Edragon/CMIOT/5_宣传彩页/02.jpg

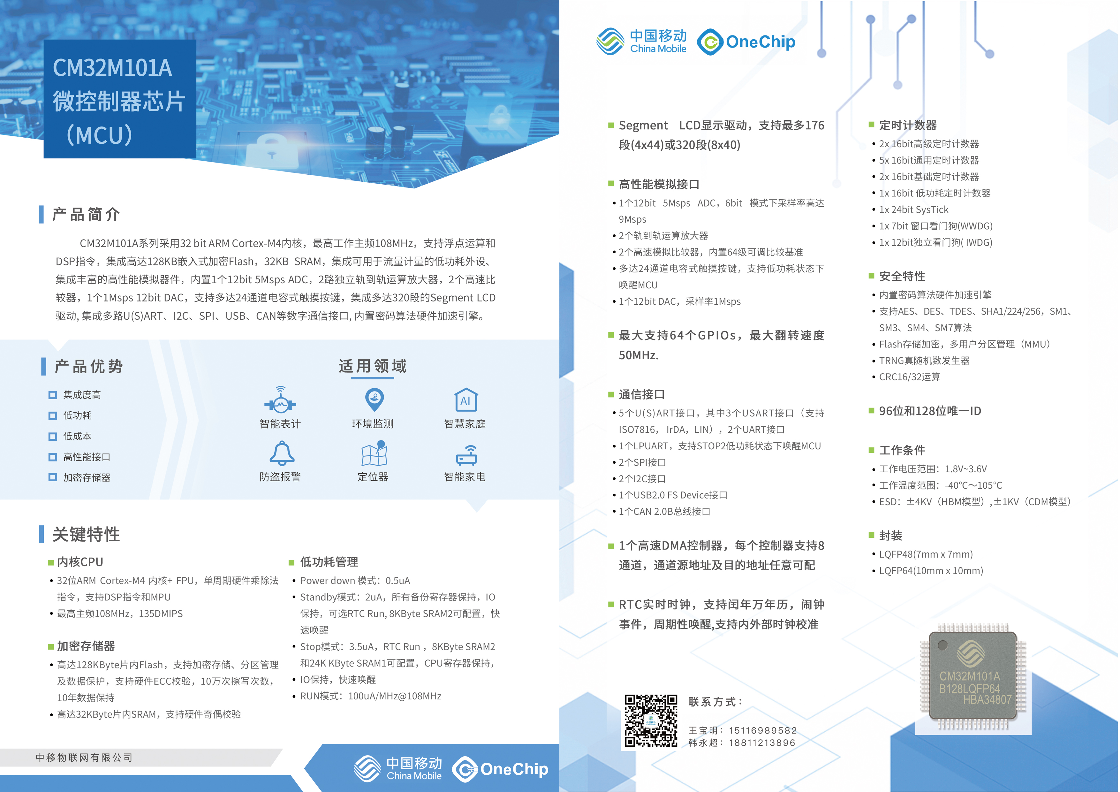
5_宣传彩页/02.jpg
