Edragon/CMIOT/5_宣传彩页/01.jpg

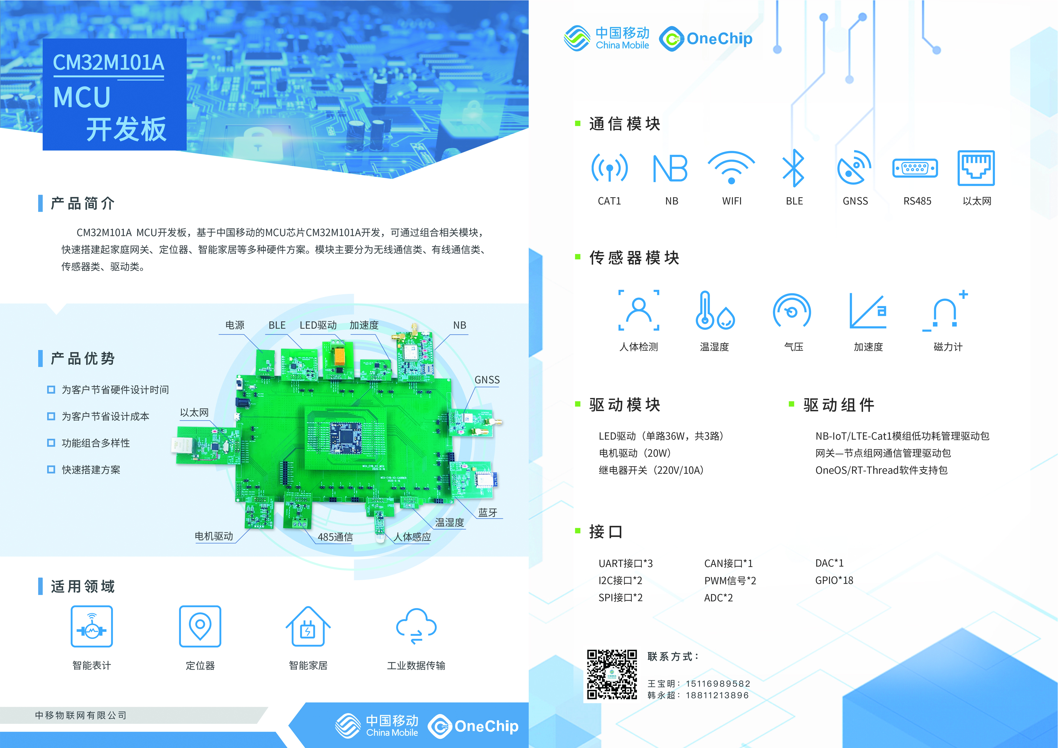
5_宣传彩页/01.jpg
