Edragon/CMIOT/4_方案板的硬件资料+含使用手册/方案板使用说明V1.1.pdf

中移物联网有限公司

# MCU 方案板使用说明

V1.1

版本 | 修改人 | 日期 | 备注
V1.0 | HuangLun | 2020.10.14 | 新建
V1.1 | HuangLun | 2020.11.27 | 增加若干内容

中移物联网有限公司

## 一、底板

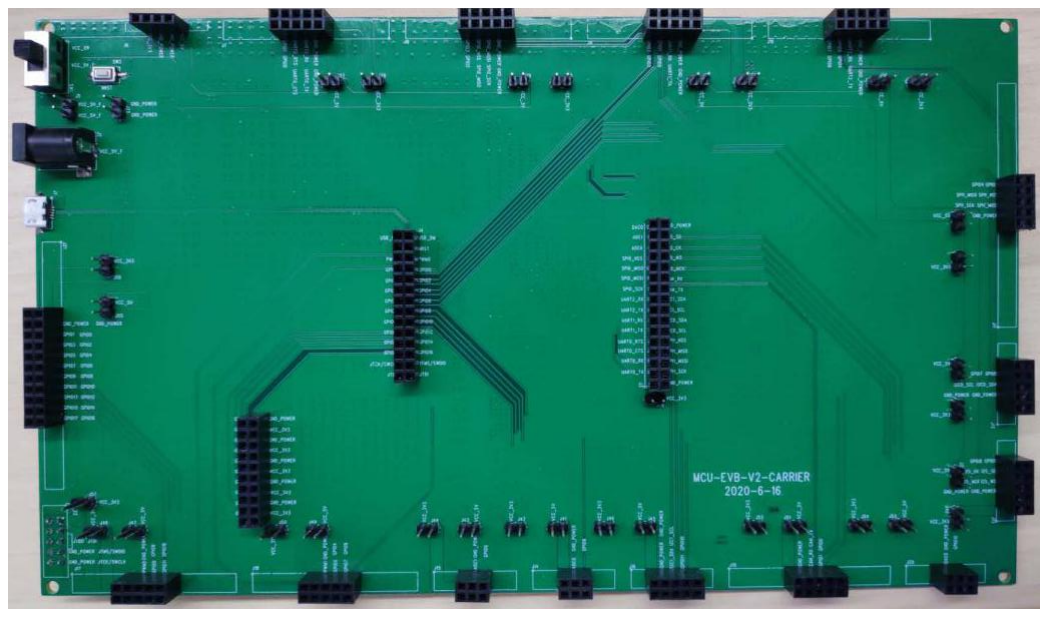
[picture p3: figure]

底板上的各模块工作，必须有电源模块。

## 1.1 电源

要求 5V 电压输出。三种输入方式：
1）适配器 DC 电源输出
2）USB 电源输入
3）其他外接电源

图 1.1.1
每个接口位置都有跳针，连接后，接口位置才通电。

比如 MCU 核心板通电，J26 跳针必须插上跳线帽。

中移物联网有限公司

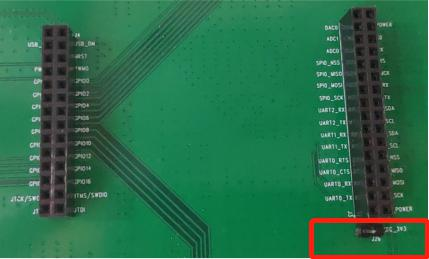
[picture p4: figure]

图 1.1.2
开关控制电源通断。按键是 MCU 的复位按键。

图 1.1.3

## 1.2 接口

各接口位置如图 1.2。

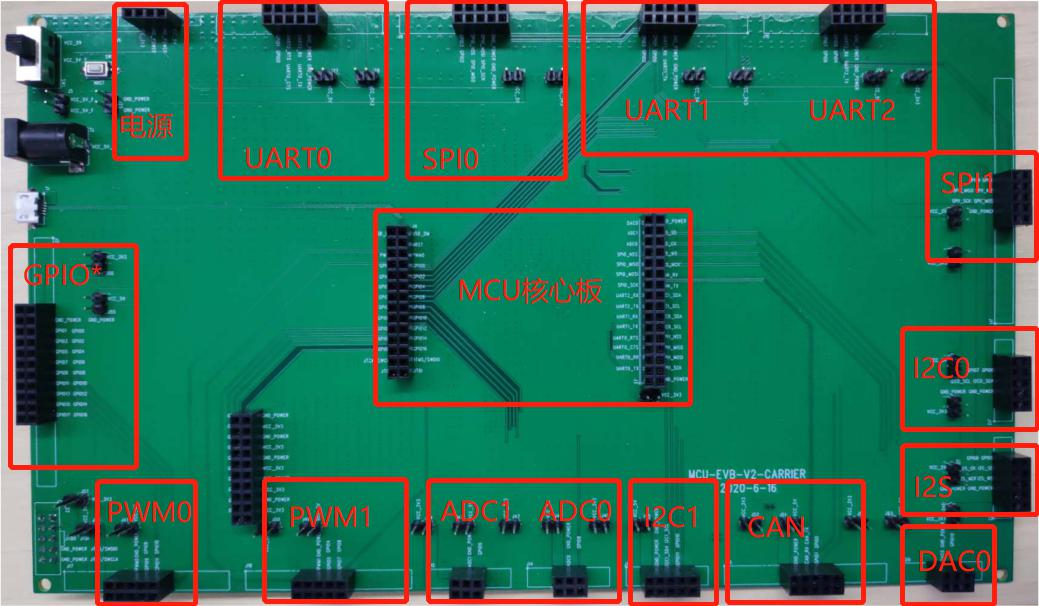
[picture p5: figure]

图 1.2

底板所有接口的 1PIN 为 5V，2PIN 为 3.3V，在底板上没有丝印。

中移物联网有限公司
从 3PIN 开始有丝印。底板各接口与 MCU 管脚对应关系见附录一。 二、MCU 核心板

## 1.1 电源

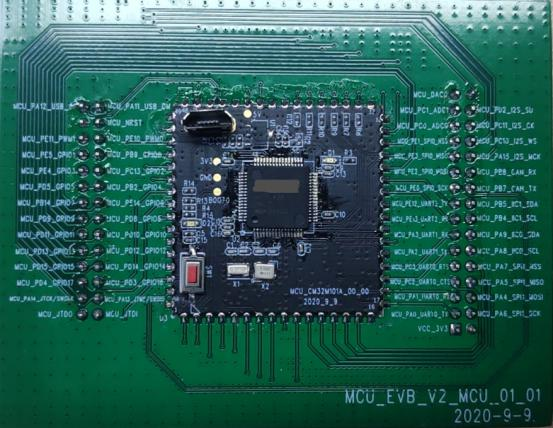
[picture p6: figure]

单独使用核心板时，可通过核心板上的 micro-USB 供电，需要焊接 R6 电阻。

核心板与底板共同使用时，由底板供电，焊接 R2。

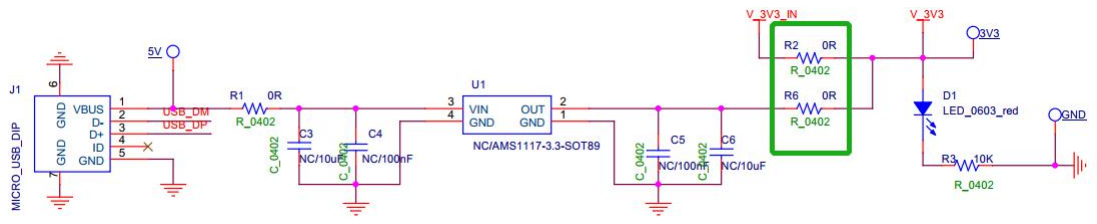
[picture p7: figure]

图 1.1

## 1.2 指示灯

电源上电指示灯为 D1。如图 1.2.1，MCU 通电电源指示灯亮。

调试指示灯 D2 连接在 PIN60_BOOT0。初上电时，BOOT0 通过 R4,R15 处于下

拉状态。如图 1.2.2。

中移物联网有限公司

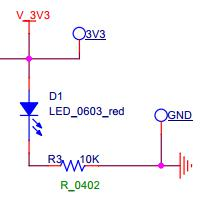
[picture p8: figure]

图 1.2.1

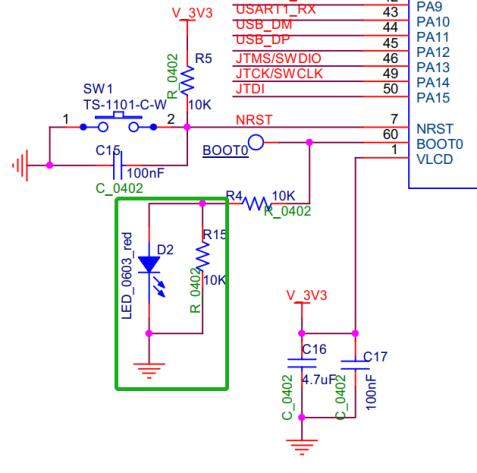
[picture p9: figure]

图 1.2.2

## 1.3 复位

板上有一枚复位按键。

图 1.3

### 1.3 核心板引出引脚（黑色板）

下图为 64PIN_MCU 所有管脚。

中移物联网有限公司

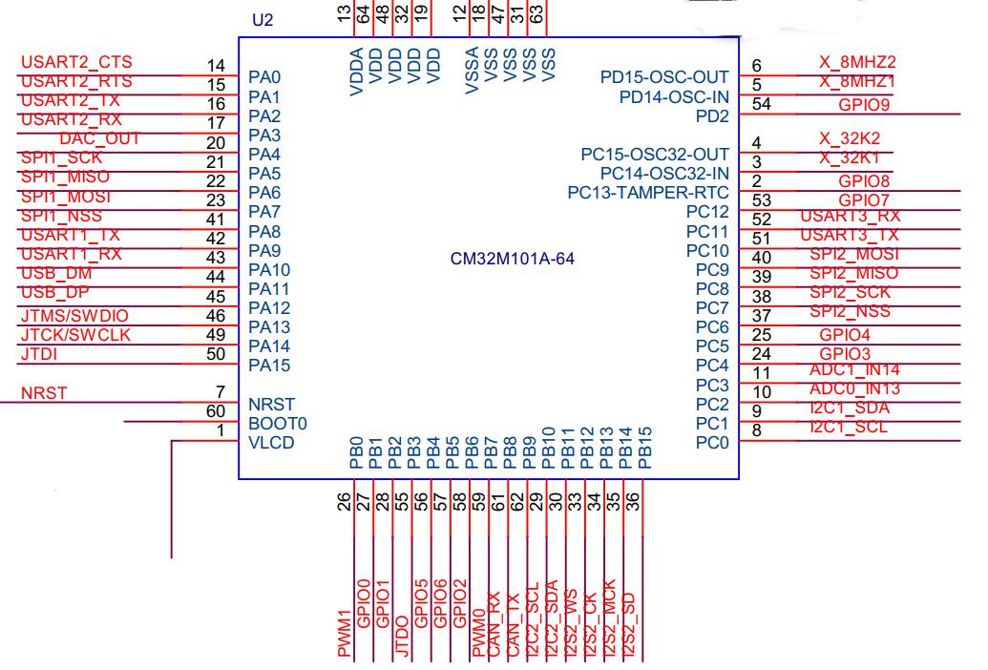
[picture p10: figure]

下图为邮票孔定义。

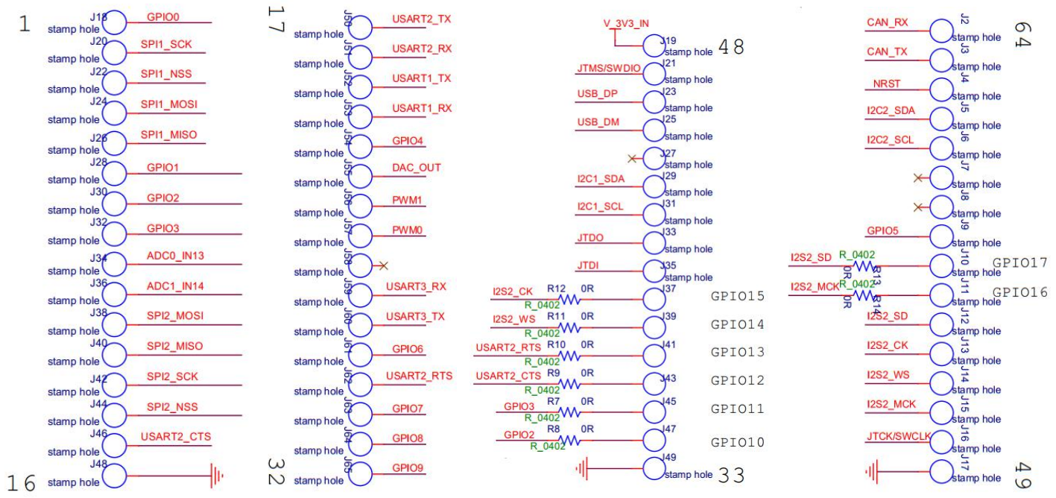
[picture p11: figure]

### 1.5 核心板与底板对应关系

核心板插在底板上，管脚对应关系见表 1.4。

表 1.4
管脚编号 | MCU 核心板管脚名称 | 底板接口对应名称
| | 复用管脚
8 | PC0 I2C1_SCL | | I2C0_SCL
9 | PC1 I2C1_SDA | | I2C0_SDA
29 | PB10 I2C2_SCL | | I2C1_SCL
30 | PB11 I2C2_SDA | | I2C1_SDA

中移物联网有限公司

33 | PB12 I2S2_WS | GPIO14 | I2S1_WS
34 | PB13 I2S2_CK | GPIO15 | I2S1_CK
35 | PB14 I2S2_MCK | GPIO16 | I2S1_MCK
36 | PB15 I2S2_SD | GPIO17 | I2S1_SD
21 | PA5 SPI1_SCK | SPI0_SCK
22 | PA6 SPI1_MISO | SPI0_MISO
23 | PA7 SPI1_MOSI | SPI0_MOSI
41 | PA8 SPI1_NSS | SPI0_NSS
37 | PC6 SPI2_NSS | SPI1_NSS
38 | PC7 SPI2_SCK | SPI1_SCK
39 | PC8 SPI2_MISO | SPI1_MISO
40 | PC9 SPI2_MOSI | SPI1_MOSI
10 | PC2 ADC0_IN13 | ADC0_IN13
11 | PC3 ADC1_IN14 | ADC1_IN14
20 | PA4 DAC_OUT | DAC_OUT
14 | PA0 USART2_CTS | GPIO12 | UART0_CTS
15 | PA1 USART2_RTS | GPIO13 | UART0_RTS
16 | PA2 USART2_TX | | UART0_TX
17 | PA3 USART2_RX | | UART0_RX
42 | PA9 USART1_TX | | UART1_TX
43 | PA10 USART1_RX | | UART1_RX
56 | PC10 | USART3_TX/UART4_TX USART3_RX/UART4_RX | | UART2_TX
57 | PC11 | | | UART2_RX
61 | PB8 CAN_RX | CAN_RX
62 | PB9 CAN_TX | CAN_TX
26 | PB0 TIM1_CH2N/TIM3_CH3 | PWM1
59 | PB7 TIM4_CH2 | PWM0
44 | PA11 USB_DM | USB_DM
45 | PA12 USB_DP | USB_DP
46 | PA13 JTMS/SWDIO | JTMS/SWDIO

中移物联网有限公司
49 | PA14 JTCK/SWCLK | JTCK/SWCLK
50 | PA15 JTDI | JTDI
55 | PB3 JTDO-TRACESWO | JTDO-TRACESWO
2 | PC13 | GPIO8 | | GPIO8
51 | PB4 | GPIO5 | | GPIO5
52 | PB5 | GPIO6 | | GPIO6
53 | PC12 | GPIO7 | | GPIO7
54 | PD2 | GPIO9 | | GPIO9
58 | PB6 | GPIO2 | GPIO10 | GPIO2
24 | PC4 | GPIO3 | GPIO11 | GPIO3
25 | PC5 | GPIO4 | | GPIO4
27 | PB1 | GPIO0 | | GPIO0
28 | PB2 | GPIO1 | | GPIO1

# 三、电源板

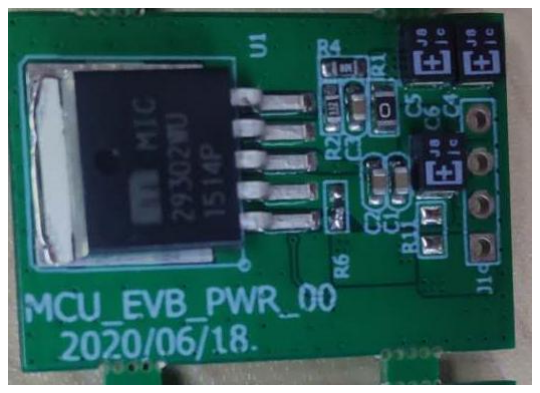
[picture p12: figure]
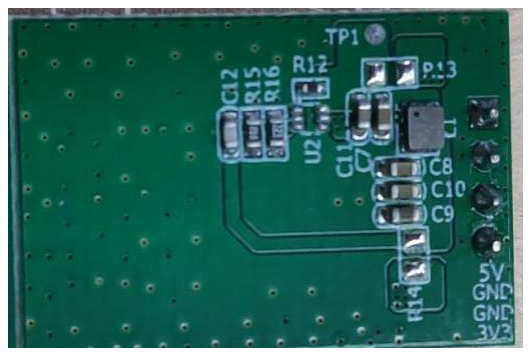
[picture p13: figure]

LDO | DC/DC

## 1.2 接口

插在底板 POWER 接口。

中移物联网有限公司

## 1.3 电源

电源有两种供电方式。只能选择一种方式供电，不能同时使用。

第一种是使用 LDO，如图 1.1。需焊接 R11,R1 电阻，同时断开另一面 R13,R14

电阻。

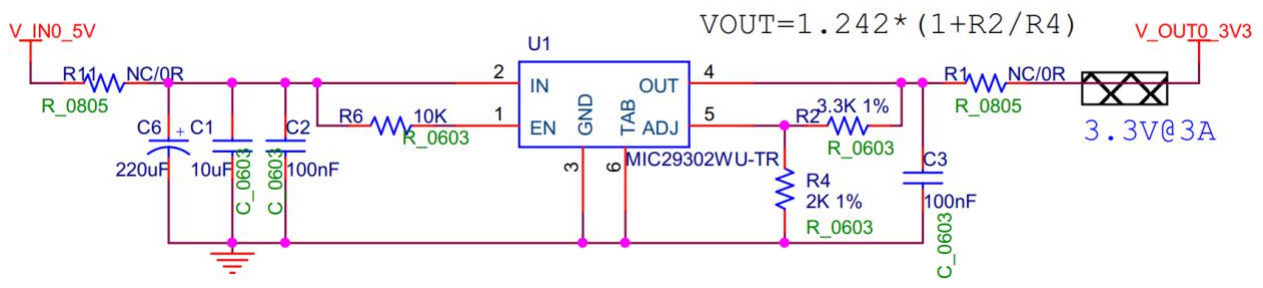
[picture p14: figure]

图 1.1
第二种是使用 DC/DC，如图 1.2，需焊接 R13,R14.同时断开 R11,R1。

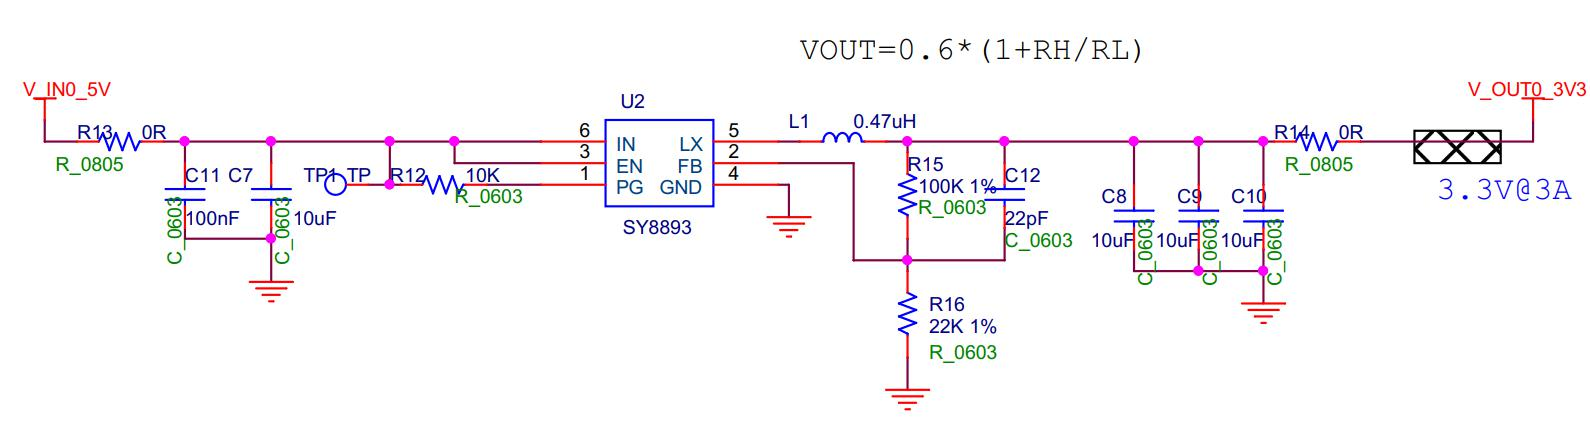
[picture p15: figure]

图 1.2

# 四、NB 板

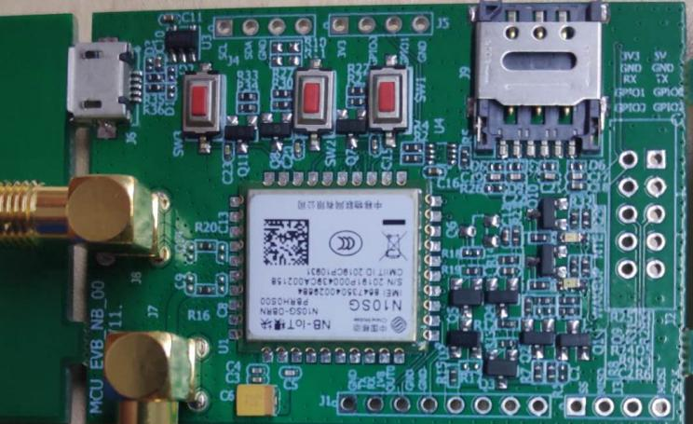
[picture p16: figure]

中移物联网有限公司

### 1.1 接口定义

接在底板 UART 接口。详见附录二。

USB 不能供电，是打印 LOG 用端口。

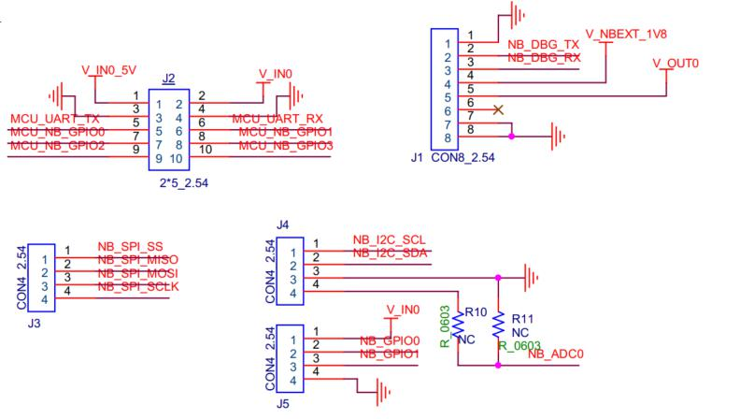
[picture p17: figure]

图 1.1

## 1.2 电源

有两种供电方式：

一是使用底板上 3.3V，焊接 R15，断开 R17。同时底板各 UART 接口的 PIN9

需要拉高；拉低时电源被关断。

二是使用 NB 板上电源供电。需焊接 R17，断开 R15。同时底板各 UART 接口

的 PIN9 需要拉高；拉低时电源被关断。

注：USB 接口不能为 NB 模组供电。

中移物联网有限公司

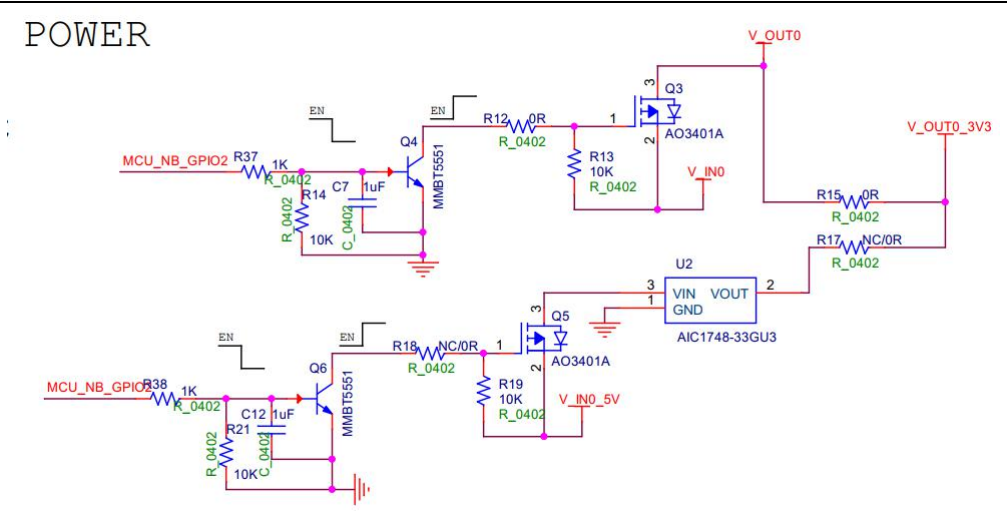
[picture p18: figure]

图 1.2.1

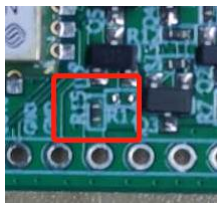
[picture p19: figure]

图 1.2.2

## 1.3 指示灯

D5 连接 wakeup_out，D4 连接 STATE。

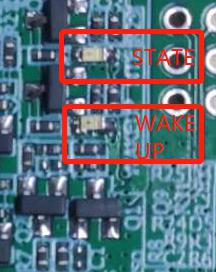
[picture p20: figure]

图 1.3

## 1.4 控制

中移物联网有限公司

# 1.4.1 复位

控制模组复位，底板各 UART 接口 PIN7 拉高复位。

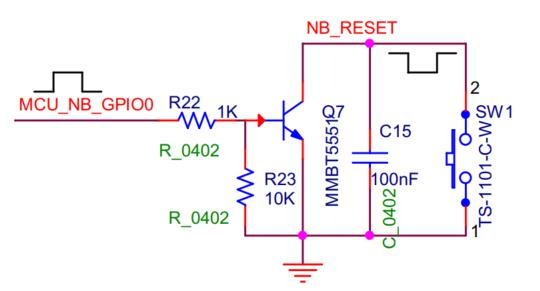
[picture p21: figure]

图 1.4.1

# 1.4.2 唤醒

唤醒模组，底板各 UART 接口 PIN8 拉高 1S 以上唤醒。

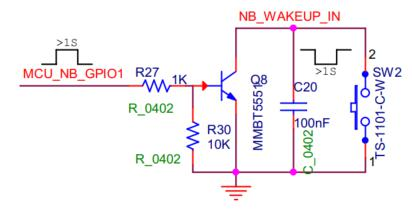
[picture p22: figure]

图 1.4.2

# 1.4.3 开机

底板各 UART 接口 PIN10 拉高 1S 以上开机。

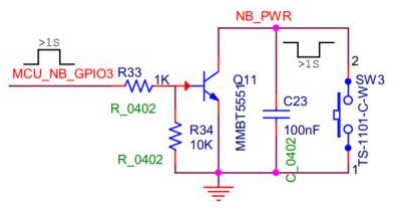
[picture p23: figure]

图 1.4.3

中移物联网有限公司

# 五、CAT1 板

### 1.1 接口定义

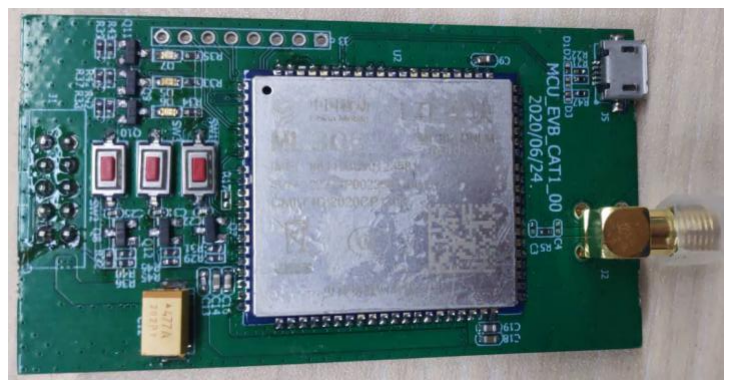
[picture p24: figure]

接在底板 UART 接口上。详见附录二。

USB 端口连接在 CAT1 USB 功能接口上。

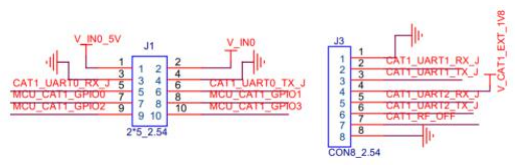
[picture p25: figure]

图 1.1

## 1.2 电源

CAT1 的电源由子板上电源单独供电。由底板输入 5V，需要连接 5V 跳针。输

出 4V。

注:USB 接口电源不能为模组供电。

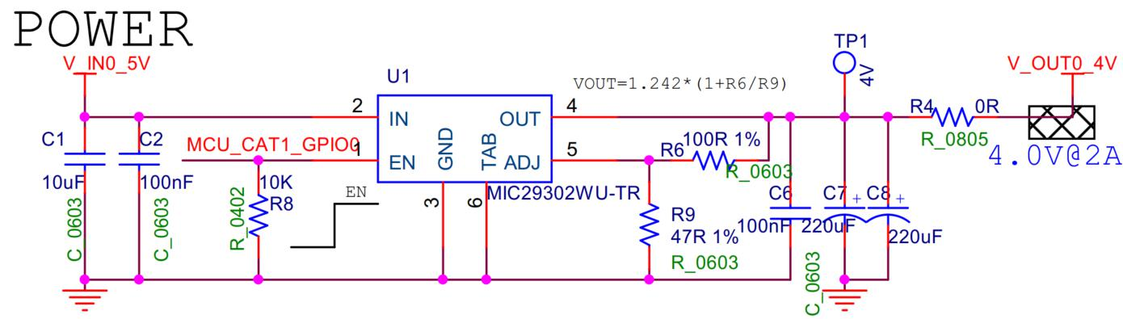
[picture p26: figure]

中移物联网有限公司
图 1.2

## 1.3 指示灯

D5 为 MOD 指示灯。D6 为 STATE 指示灯。D7 为 wakeup 指示灯。

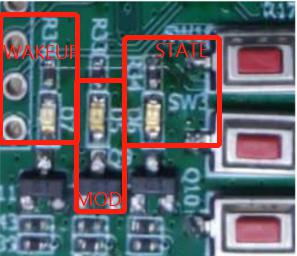
[picture p27: figure]

图 1.3

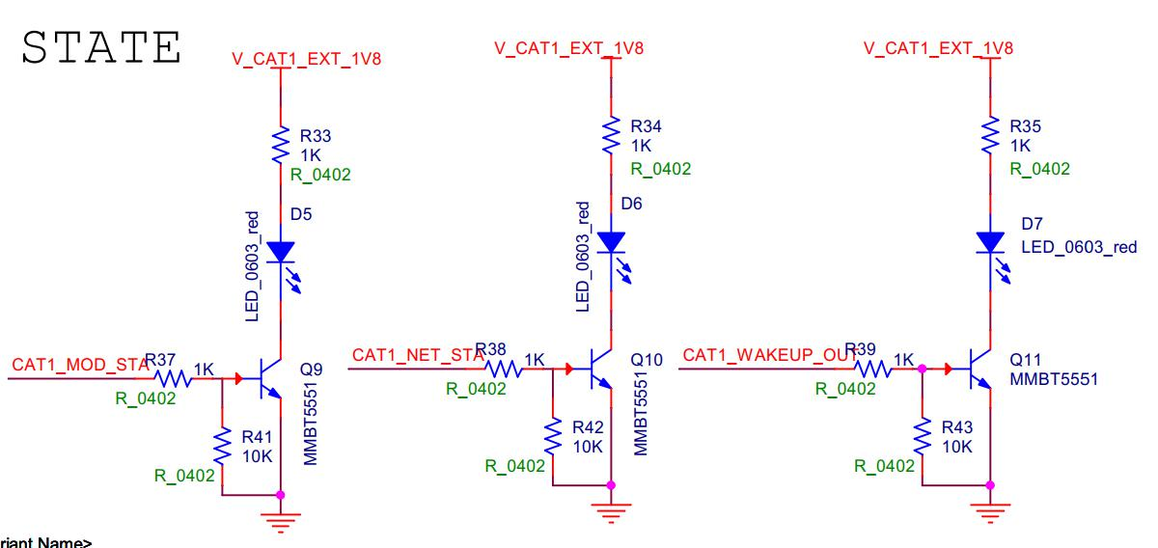
[picture p28: figure]

## 1.4 控制

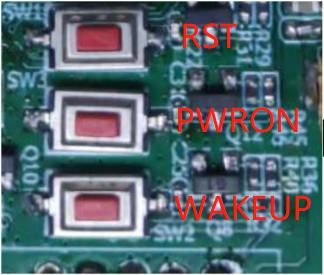
[picture p29: figure]

图 1.4

中移物联网有限公司

# 1.4.1 复位

控制模组复位，底板各 UART 接口 PIN8 拉高复位。

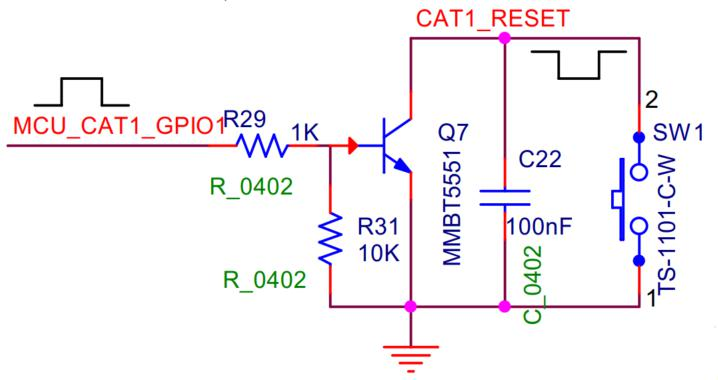
[picture p30: figure]

图 1.4.1

# 1.4.2 唤醒

唤醒模组，底板各 UART 接口 PIN9 拉低 1S 以上唤醒。

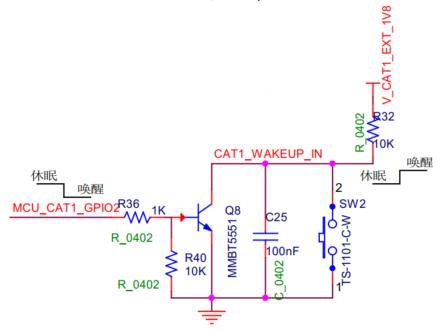
[picture p31: figure]

图 1.4.2

# 1.4.3 开机

底板各 UART 接口 PIN10 拉高 1S 以上开机。

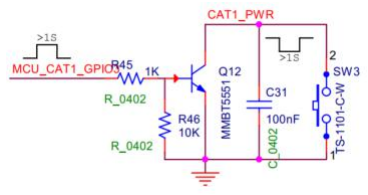
[picture p32: figure]

图 1.4.3

中移物联网有限公司

# 六、GNSS 板

## 1.1 接口

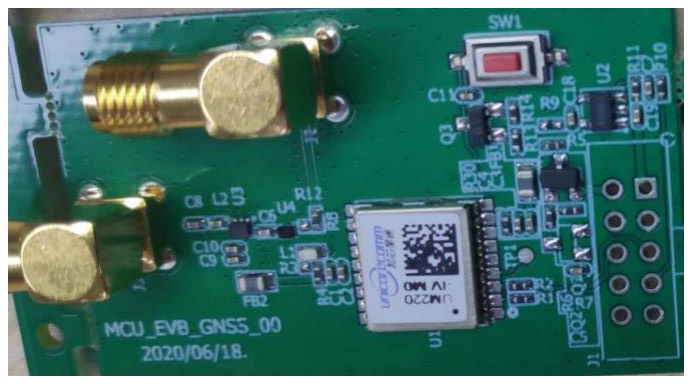
[picture p33: figure]

接在底板 UART 接口。详见附录二。

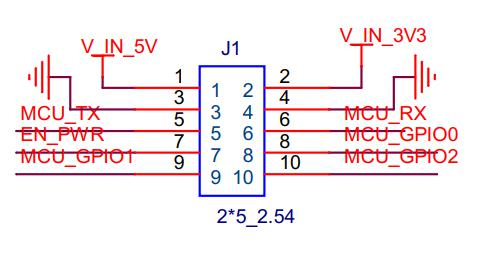
[picture p34: figure]

图 1.1

## 1.2 电源

有两种供电方式，

一是使用底板上 3.3V，焊接 R5，断开 R9。同时各 UART 接口的 PIN7 需要拉

高；拉低时电源被关断。

二是使用 GNSS 板上电源供电。需焊接 R9，断开 R5。同时各 UART 接口的 PIN7

需要拉高；拉低时电源被关断。

中移物联网有限公司

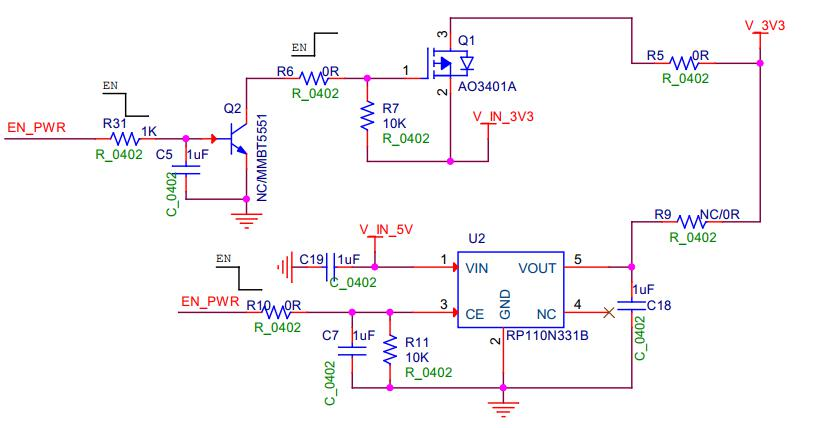
[picture p35: figure]

图 1.2.1

图 1.2.2

## 1.3 控制

控制模组复位，底板各 UART 接口 PIN8 拉高复位。

图 1.3.1

## 1.4 天线

使用有源天线时，天线连接 J2，需焊接 0 欧姆电阻 R8,R3，断开 R4,R12。

使用无源 RF 时，天线连接在 J3，焊接 0 欧姆电阻 R4,R12，断开 R8,R3。

中移物联网有限公司

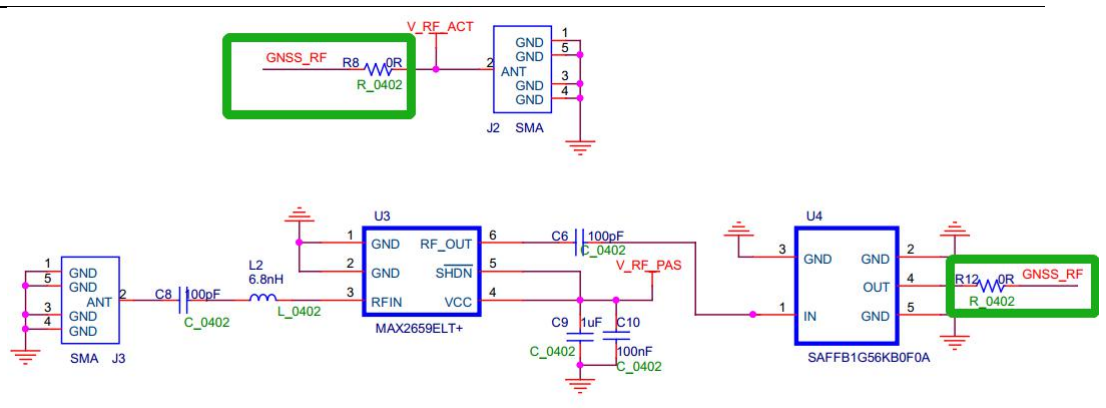
[picture p36: figure]

图 1.4.1

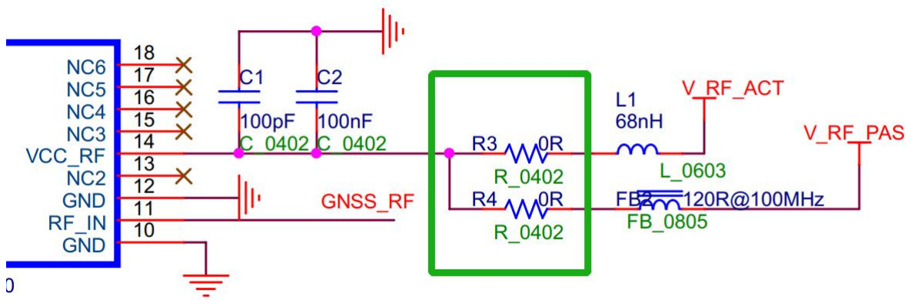
[picture p37: figure]

图 1.4.2

图 1.4.3

中移物联网有限公司

# 七、蓝牙板

## 1.1 接口

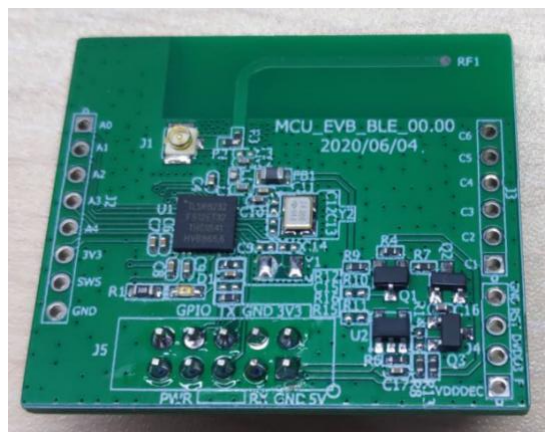
[picture p38: figure]

接在底板 UART 接口。详见附录二。

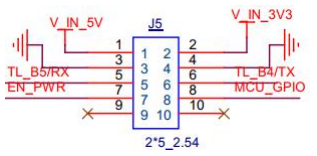
[picture p39: figure]

图 1.1

## 1.2 电源

有三种供电方式：

一是插在底板上后，电源直接连通：需焊接 R9 电阻，断开 R10、R11。

二是使用底板上 3.3V，焊接 R10，断开 R9、R11。同时各 UART 接口的 PIN7

需要拉高；拉低时电源被关断。

三是使用蓝牙板上电源供电。需焊接 R11，断开 R9、R10。同时各 UART 接口

的 PIN7 需要拉高；拉低时电源被关断。

中移物联网有限公司
图 1.2

## 1.3 指示灯

指示灯接在蓝牙芯片的 PIN15_P1。输出高，指示灯亮。

图 1.3

## 1.4 天线

焊接 R3 使用板载天线；焊接 R2 使用外接天线。

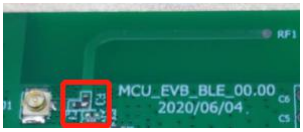
[picture p40: figure]

图 1.4

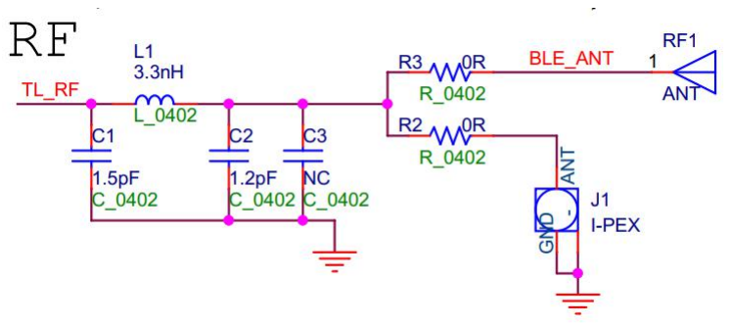
[picture p41: figure]

中移物联网有限公司

# 八、WIFI 板

## 1.1 接口

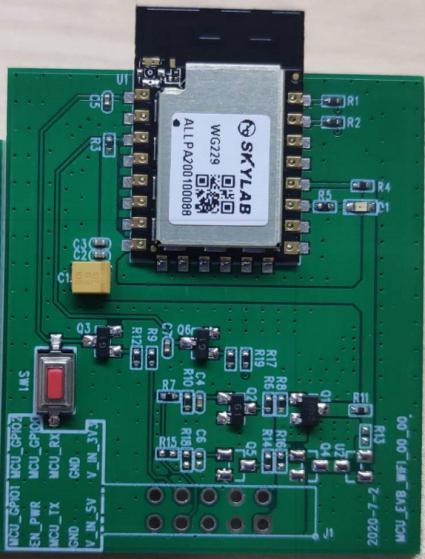
[picture p42: figure]

接口接在底板 UART 接口。详见附录二。

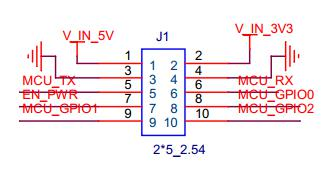
[picture p43: figure]

图 1.1

## 1.2 电源

电源有两种供电方式；两个供电方式不能同时使用。为使 wifi 板上电，都

需要将 UART 接口 PIN7 管脚拉高。

第一种使用底板上 3.3V 电源，需焊接 R11，断开 R13。为了更低功耗可断开

R15。

第二种使用 WIFI 板上 LDO，需焊接 R13,断开 R11。

中移物联网有限公司

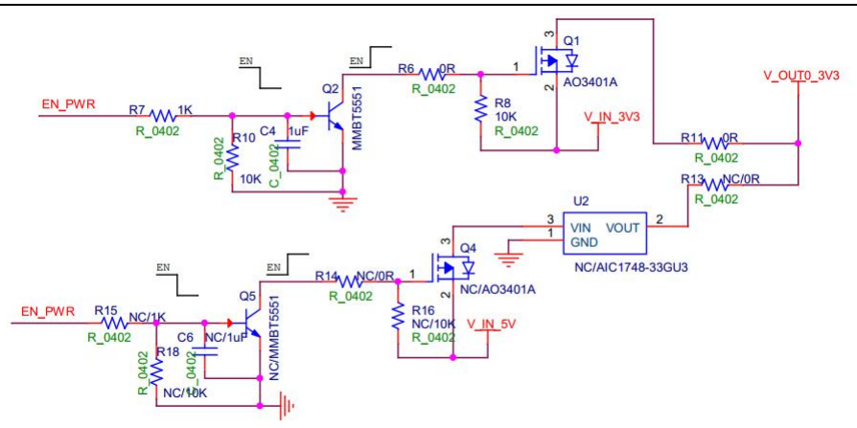
[picture p44: figure]

图 1.2.1

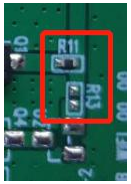
[picture p45: figure]

图 1.2.2

## 1.3 指示灯

指示灯接在 WIFI 模组的 PIN17—GPIO2 引脚，输出低电平时，指示灯亮起。

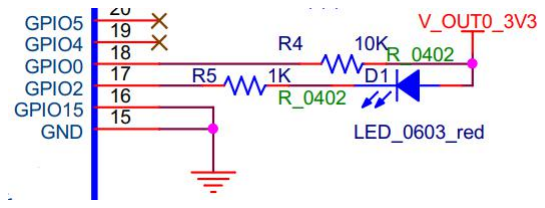
[picture p46: figure]

图 1.3.1

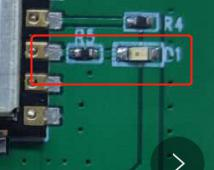
[picture p47: figure]

图 1.3.2

中移物联网有限公司

## 1.4 控制

图 1.4 分别是控制 wifi 模组的复位信号和使能信号。

复位 RST 信号，需底板 UART 接口的 PIN8 管脚输出高。

使能 EN 信号，需底板 UART 接口的 PIN9 管脚输出高。

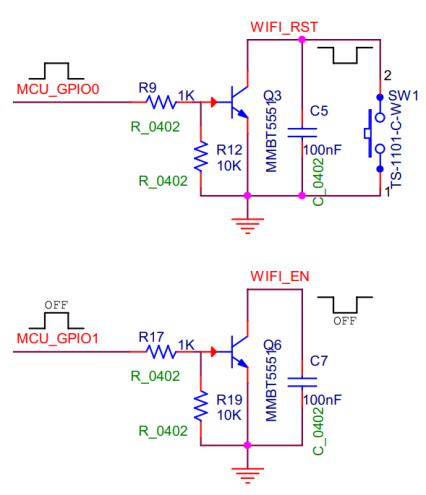
[picture p48: figure]

图 1.4

# 九、RS485 板

## 1.1 接口

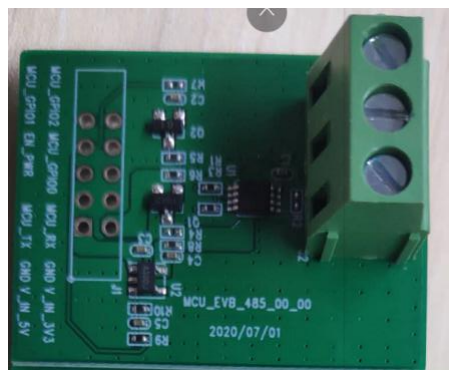
[picture p49: figure]

接在底板 UART 接口。详见附录二。

中移物联网有限公司

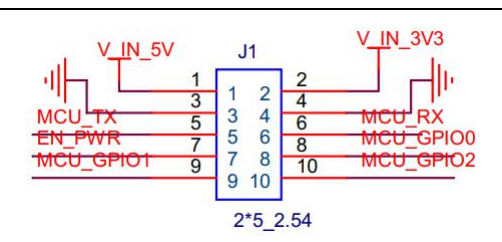
[picture p50: figure]

图 1.1

## 1.2 电源

电源有两种供电方式，如图 1.2。两个供电方式不能同时使用。为使 RS485

板上电，都需要将底板 UART 接口 PIN7 管脚拉高。

第一种使用底板上 3.3V 电源，需焊接 R4，断开 R8。为了更低功耗可断开

R9。

第二种使用子板上 LDO，需焊接 R8,断开 R4。

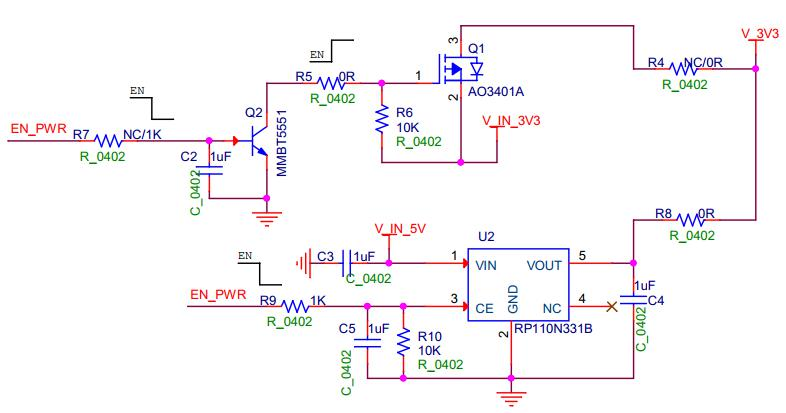
[picture p51: figure]

图 1.2.1

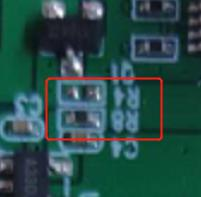
[picture p52: figure]

图 1.2.2

中移物联网有限公司

## 1.3 工作

通过 RS485 芯片的 PIN2 与 PIN3 控制数据的传输方向；即底板 UART 接口 PIN8

管脚。长距离通信时需焊接上 R2。

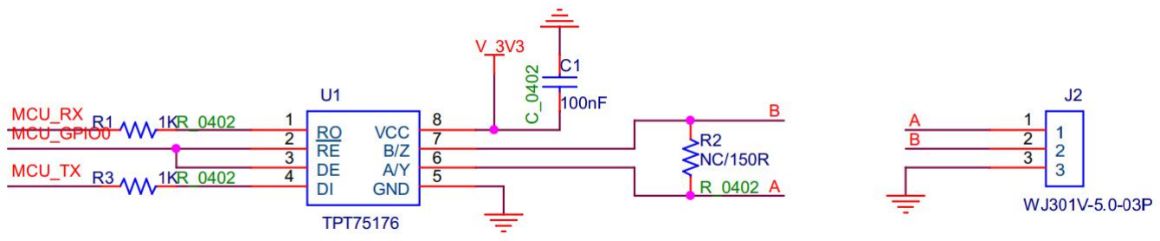
[picture p53: figure]

图 1.3

GPIO0 的控制收发功能真值表如下表。

表 1.3.1

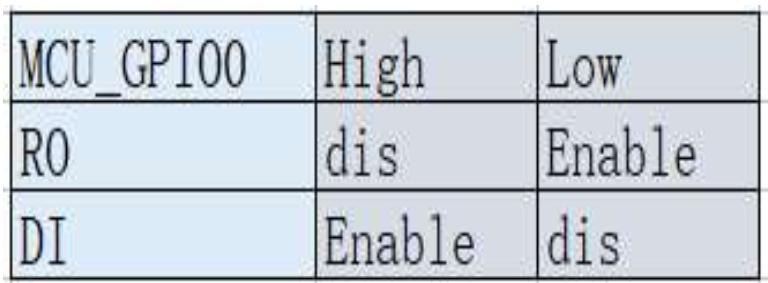
[picture p54: figure]

# 十、以太网板

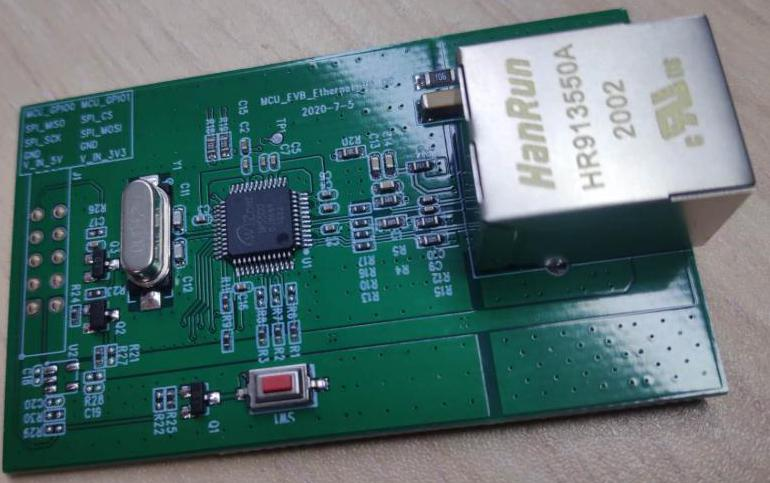
[picture p55: figure]

中移物联网有限公司

## 1.1 接口

接在底板的 SPI 接口。详见附录三。

## 1.2 电源

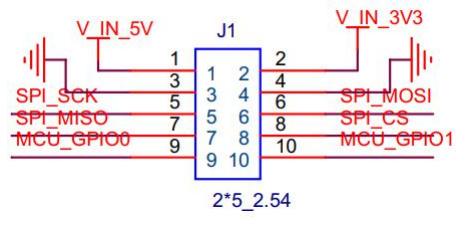
[picture p56: figure]

电源有三种供电方式，三个供电方式不能同时使用。为使以太网板上电，前

两种方式需要将底板 SPI 接口 PIN9 管脚拉高。

第一种使用底板上 3.3V 电源，需焊接 R21，断开 R27，R28。为了更低功耗

可断开 R29。

第二种使用本子板上 LDO，需焊接 R28,断开 R21，R27。

第三种不使用控制，直接上电，需焊接 R27，断开 R21,R28

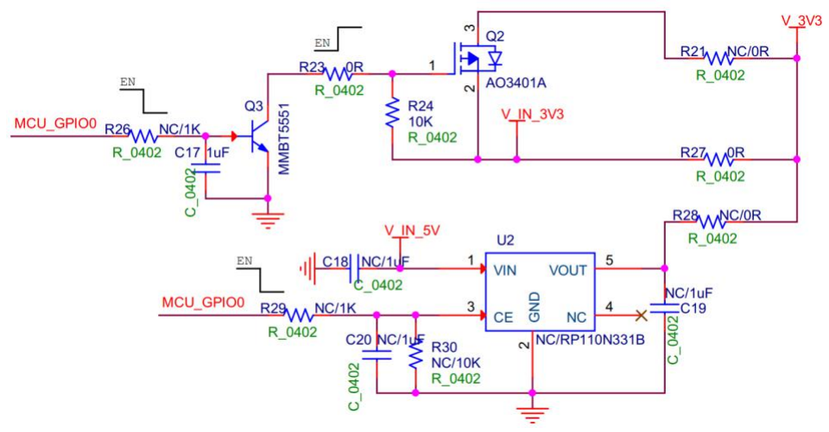
[picture p57: figure]

图 1.2.1

中移物联网有限公司

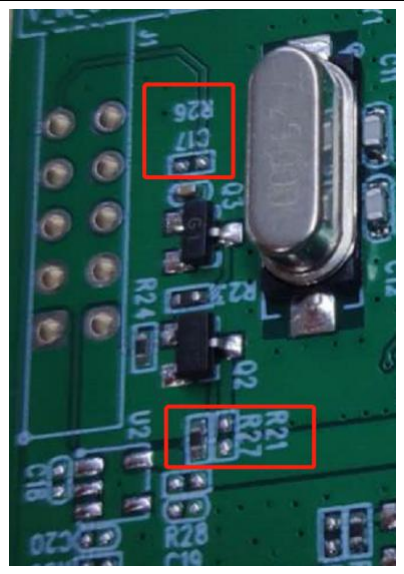
[picture p58: figure]

图 1.2.2

## 1.3 控制

复位信号需将底板 SPI 接口 PIN9 管脚拉高。

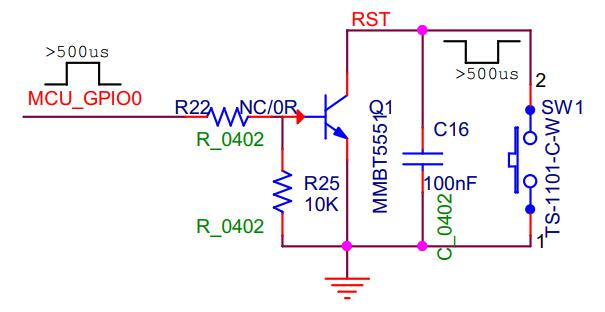
[picture p59: figure]

图 1.3

## 1.4 中断

中断信号接在底板 SPI 接口 PIN10 管脚。

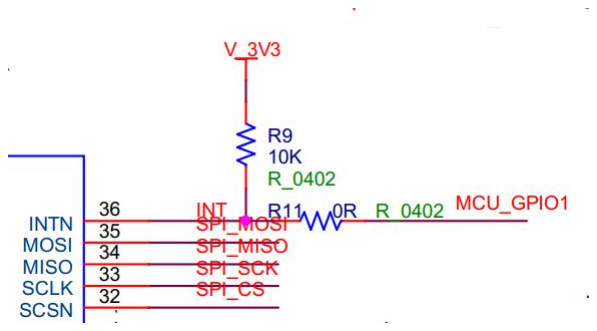
[picture p60: figure]

图 1.4

中移物联网有限公司

### 1.5 模式设置

通过 R1,R2,R3,R6,R7,R8 设置工作模式。

PHYMODE 的设置见表 1.5。

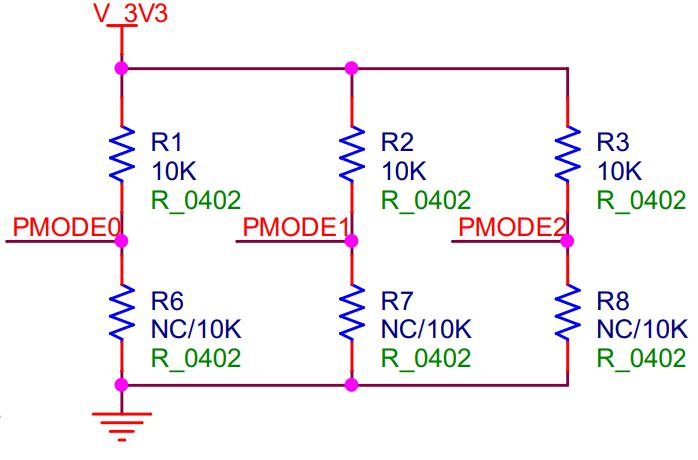
[picture p61: figure]

图 1.5.1

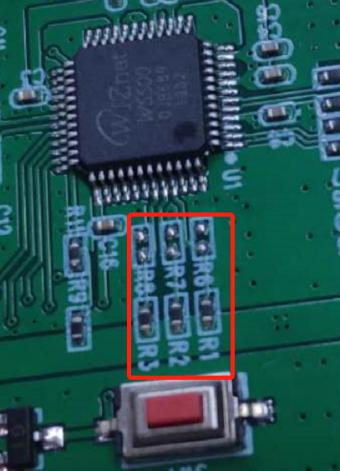
[picture p62: figure]

图 1.5.2

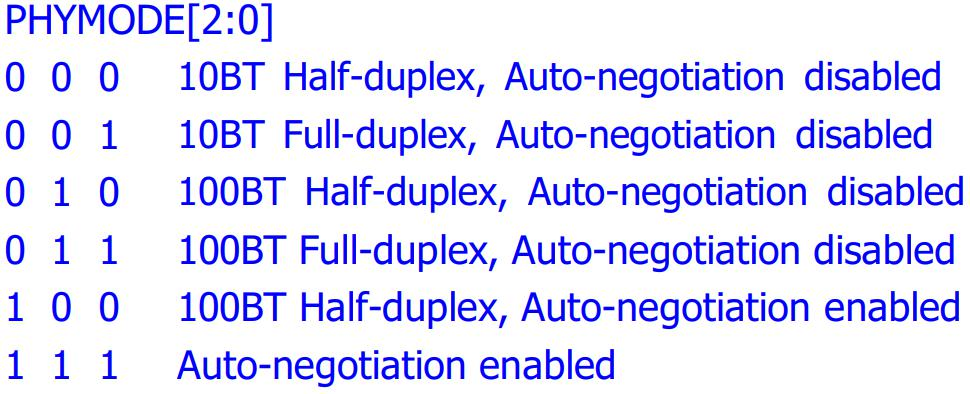
[picture p63: figure]

表 1.5

中移物联网有限公司

# 十一、电机驱动板

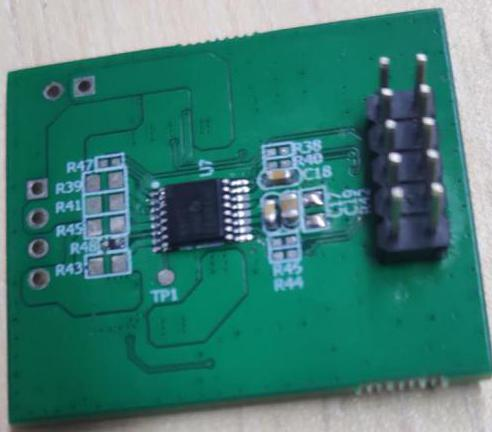
[picture p64: figure]
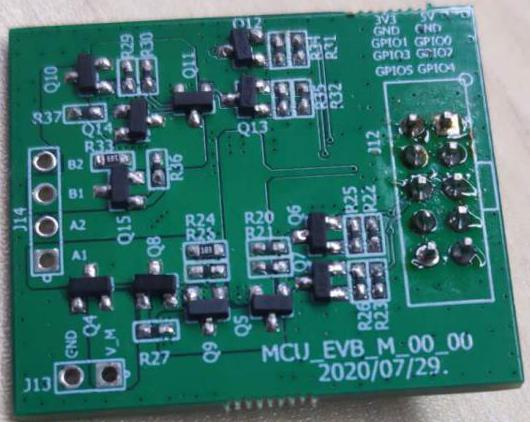
[picture p65: figure]

TOP | BOTTOM

## 1.1 接口

J12 时 GPIO 接口，使用时，要关注 GPIO 是否和底板其他接口冲突。 J13 是电机的电源输入接口。
J14 接步进电机的四路。

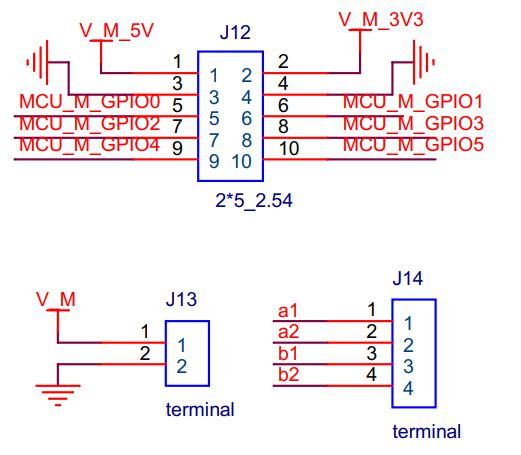
[picture p66: figure]

图 1.1.1

中移物联网有限公司

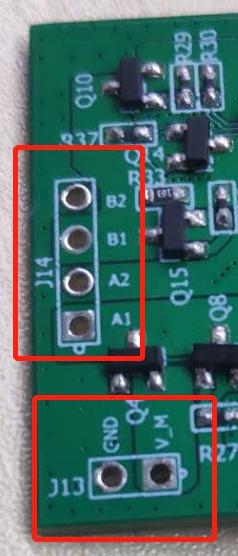
[picture p67: figure]

图 1.1.2

## 1.2 电源

电机的电源由 J13 外部输入。见图 1.1.2。

### 1.3 驱动方式

驱动方式有两种，一种是 MOS 电路驱动。如图 1.3.1

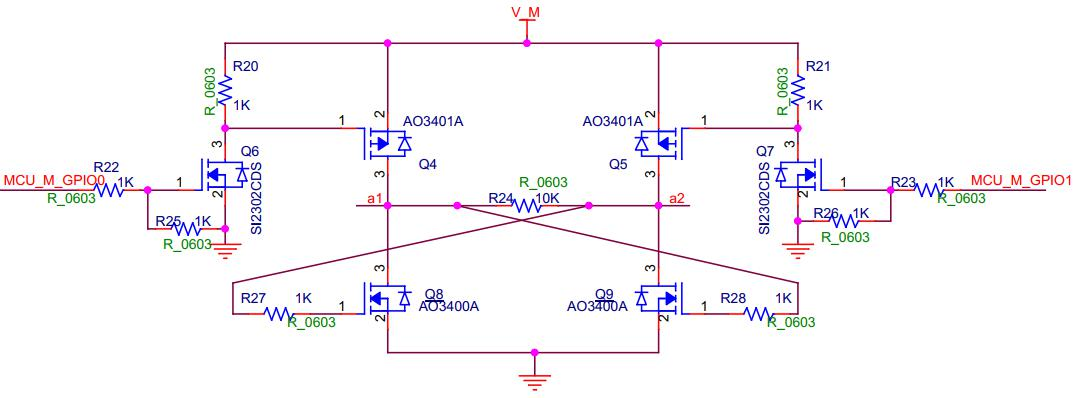
[picture p68: figure]

中移物联网有限公司

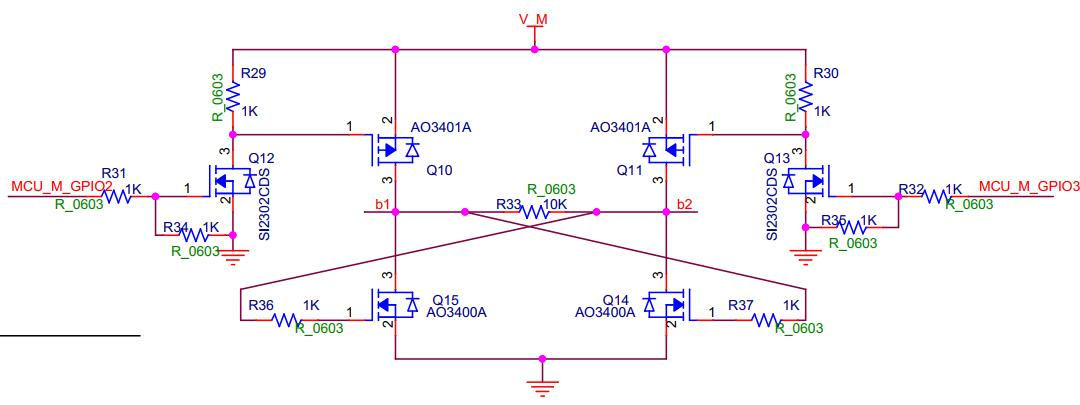
[picture p69: figure]

图 1.3.1
另一种是通过 IC 驱动。如图 1.3.2，默认情况使用 MOS 电路驱动，使用 IC 时，需要将 Q4,Q5,Q8,Q9,Q10,Q11,Q15,Q14 全部断开。

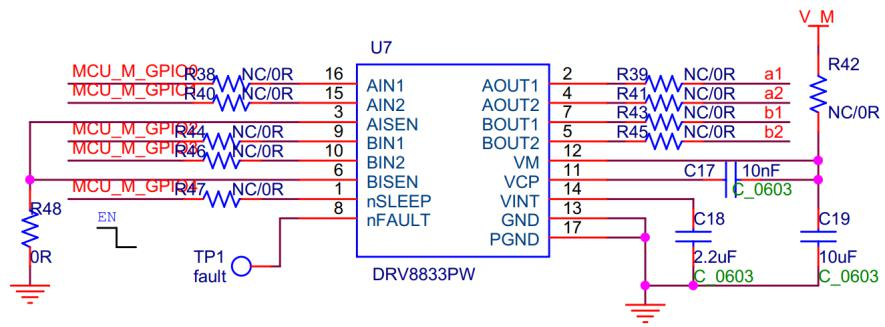
[picture p70: figure]

图 1.3.2

### 1.4 MOS 驱动方式工作逻辑

使用 MOS 管驱动时，GPIO 的工作逻辑见表 1.4。

表 1.4
节点 | 电平 | 优先级 | 电流流向
GPIO0 | L | 2 | V_M->Q5->a2->外部线圈->a1->Q8->GND
GPIO1 | H | 1
a1 | GND | /
a2 | V_M
节点 | 电平 | 优先级 | 电流流向
GPIO0 | H | 1 | V_M->Q4->a1->外部线圈->a2->Q9->GND
GPIO1 | L | 2
a1 | V_M | /

中移物联网有限公司
a2 | GND
注：GPIO0 与 GPIO1 不能同时出现高电平
节点 | 电平 | 优先级 | 电流流向
GPIO2 | L | 2 | V_M->Q11->b2->外部线圈->b1->Q15->GND
GPIO3 | H | 1
b1 | GND | /
b2 | V_M
节点 | 电平 | 优先级 | 电流流向
GPIO2 | H | 1 | V_M->Q10->b1->外部线圈->b2->Q14->GND
GPIO3 | L | 2
b1 | V_M | /
b2 | GND
注：GPIO2 与 GPI03 不能同时出现高电平

# 十二、9 轴板

## 1.1 接口

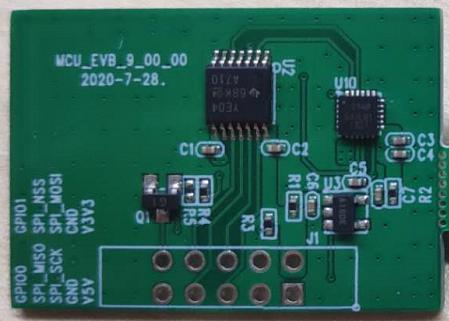
[picture p71: figure]

SPI 接口。详见附录三。

中移物联网有限公司

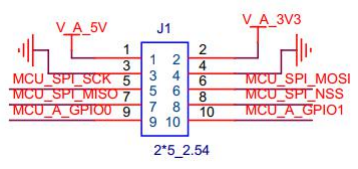
[picture p72: figure]

图 1.1

## 1.2 电源

9 轴传感器由 1.8V 供电。底板 SPI 接口的 PIN9 管脚控制电源上电，高电平

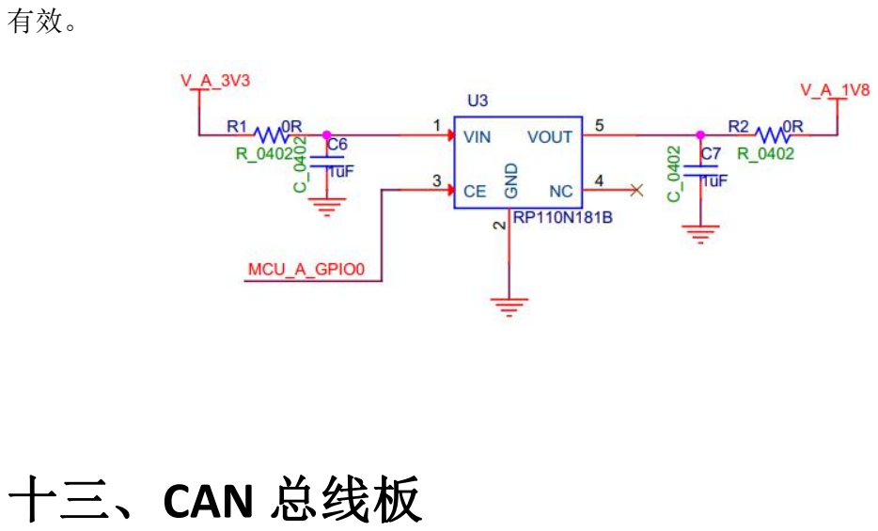
[picture p73: figure]
有效。 十三、CAN 总线板
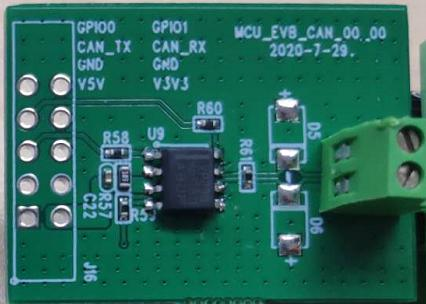
[picture p74: figure]

中移物联网有限公司

## 1.1 接口

连接底板的 CAN 总线接口。

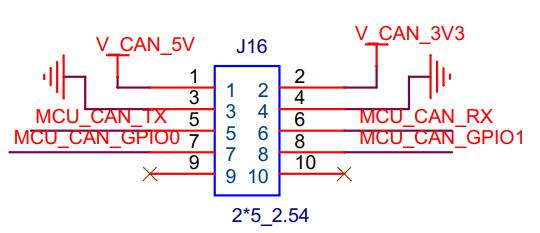
[picture p75: figure]

CAN 接口 | CAN 模块
CAN_TX | /
CAN_RX | /
GPIO0 | 速率设置（配置低）
GPIO1

图 1.1

## 1.2 电源

电源由底板上 3.3V 直接供电。

## 1.3 工作

（1）GPIO0 是控制速率管脚，一般情况需要拉低。

（2）进行长距离通信，R61 需焊接 120R 电阻

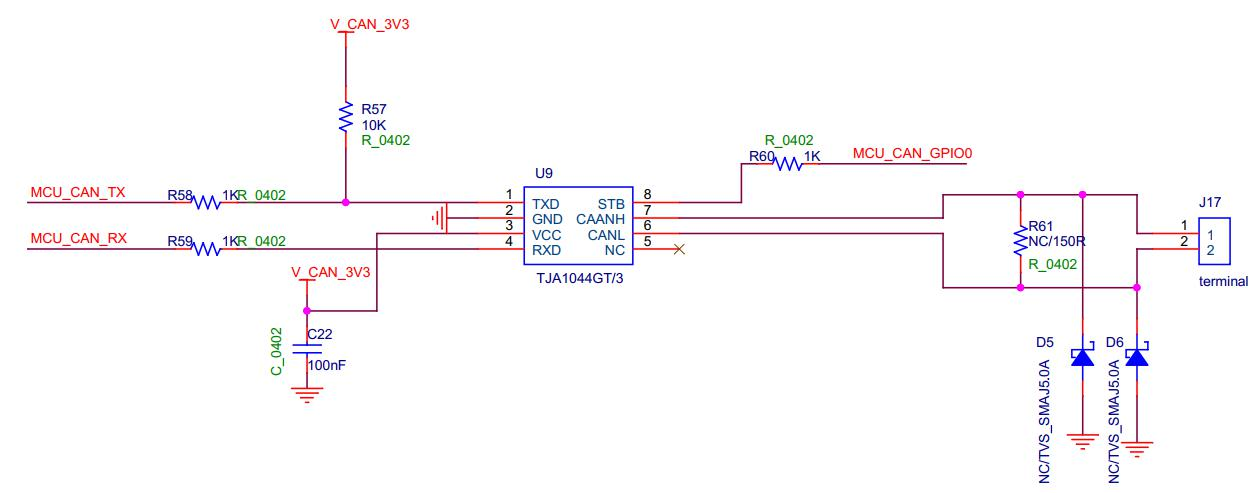
[picture p76: figure]

图 1.3.1

中移物联网有限公司

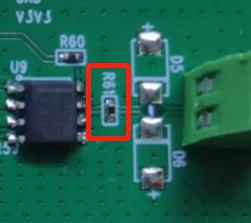
[picture p77: figure]

图 1.3.2

# 十四、湿度测量板

## 1.1 接口

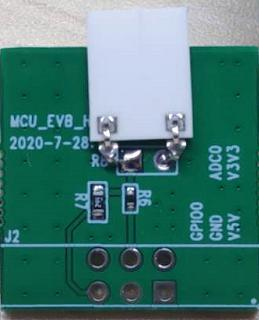
[picture p78: figure]

子板接在底板 ADC 接口。

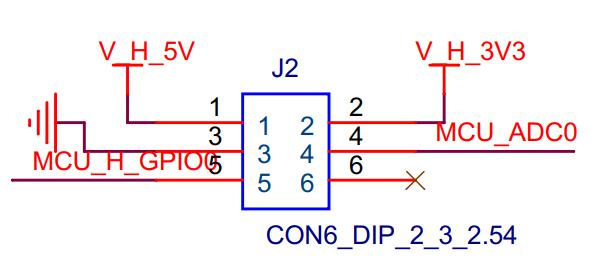
[picture p79: figure]

图 1.1

ADC0 接口 | ADC1 接口 | 湿度测量
ADC0 | ADC1 | ADC 采样
GPIO8 | GPIO9 | 发送方波

中移物联网有限公司

## 1.2 电路

底板 ADC 接口的 PIN5 需要输出 1KHz 的方波，更该电阻 R8 调节

灵敏度。

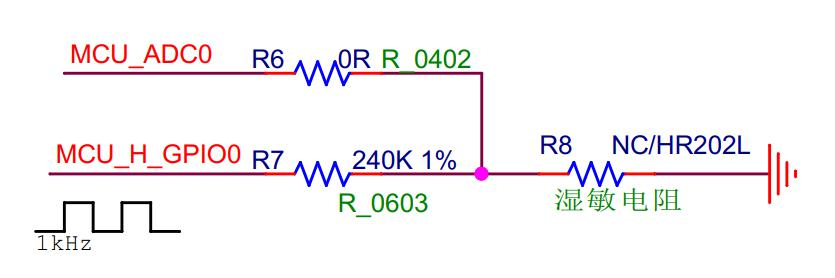
[picture p80: figure]

图 1.2

# 十五、人体检测板

## 1.1 接口

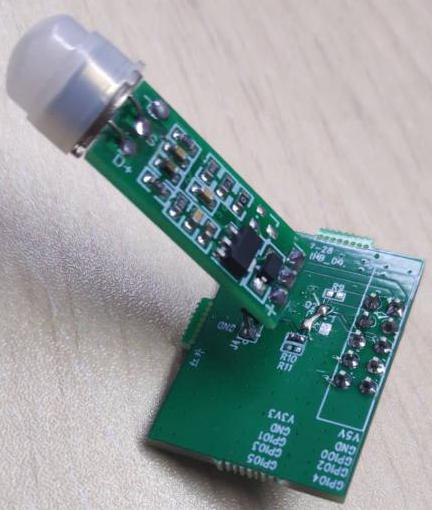
[picture p81: figure]

接在 GPIO 接口上。需要用到一路 GPIO。

中移物联网有限公司
GPIO 接口 | 人体检测
GPIO0 | 接收电平变化

## 1.2 电源

电源由底板 5V 供电。

### 1.3 工作方式

当检测到人体时，输出高电平。8S 钟后输出低电平。

距离和延时时间可通过下图电阻调整。

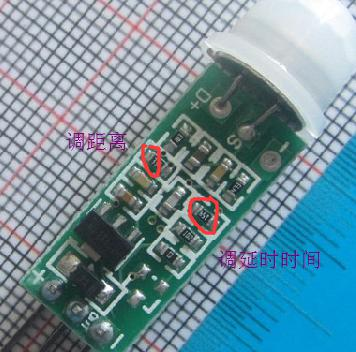
[picture p82: figure]

中移物联网有限公司

# 十六、继电器板

## 1.1 接口

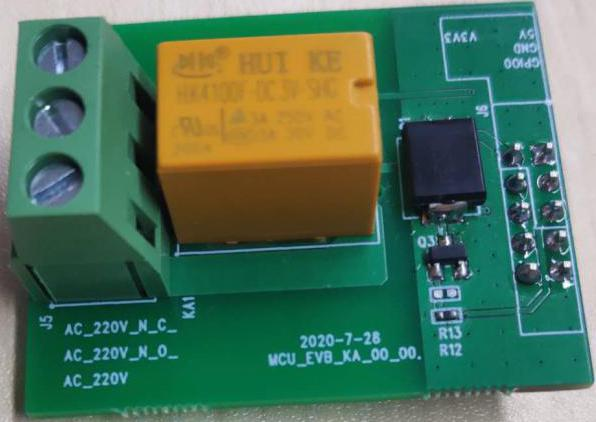
[picture p83: figure]

接在底板 GPIO 接口上。需要用到一路 GPIO。

GPIO 接口 | 继电器
GPIO0 | 控制开关

## 1.2 工作

电路如图所示。常开接在 N.O,常闭接在 N.C。

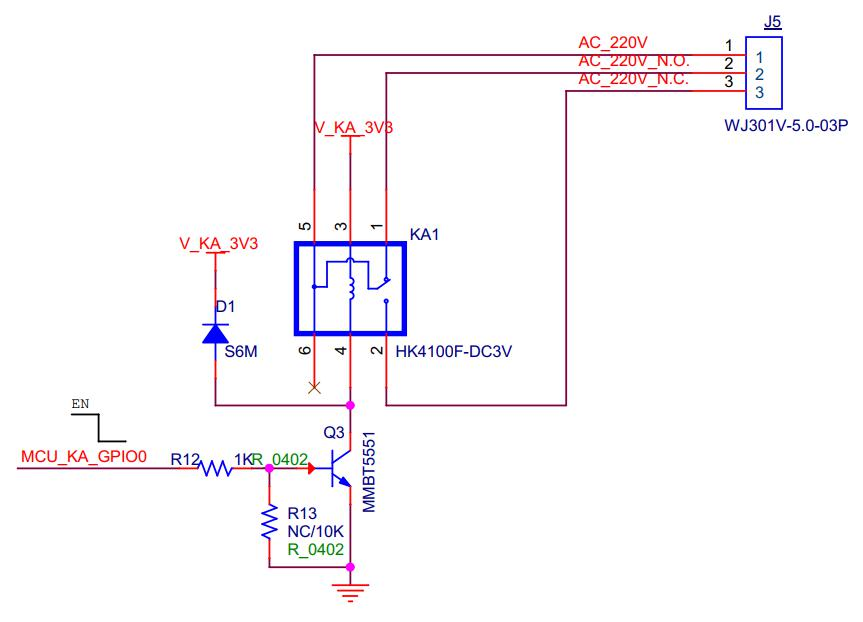
[picture p84: figure]

图 1.2

中移物联网有限公司

# 十七、LED 驱动板

## 1.1 接口

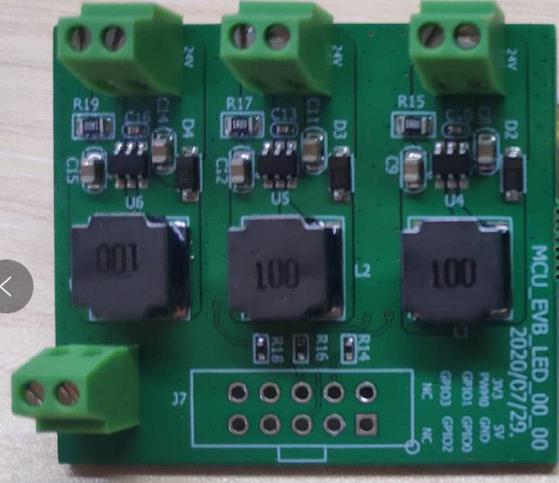
[picture p85: figure]

接在底板 PWM 接口上。每块子板上三鹿 LED 驱动，每一路驱动都需要一路

PWM 控制。因此需要底板 PWM 接口上 PIN5 和 PIN6 的 GPIO 模拟 PWM。

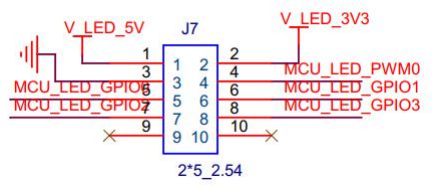
[picture p86: figure]

图 1.1.1

PWM1 | LED 驱动
PWM1 | 第一路 PWM
GPIO4 | 第二路 PWM
GPIO5 | 第三路 PWM
GPIO6 | /
GPIO7 | /

中移物联网有限公司
J9,J10.J11 是三路输出接口。24V_*接 LED 正极，FB_*接负极。

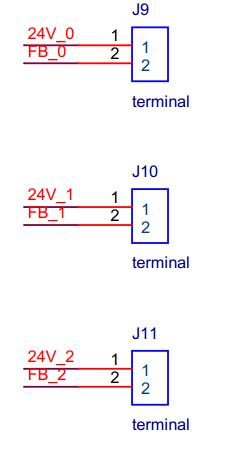
[picture p87: figure]

图 1.1.2

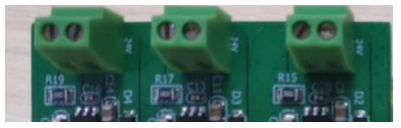
[picture p88: figure]

图 1.1.3

## 1.2 电源

输入电源由外部接口提供。

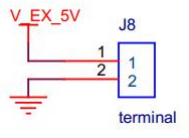
[picture p89: figure]

图 1.2.1

图 1.2.2

中移物联网有限公司

### 1.3 工作原理

驱动 IC 是流控驱动型芯片，调整 R15 控制最大输出电流。详见芯片手册。

芯片型号为圣邦微 SGM3749。

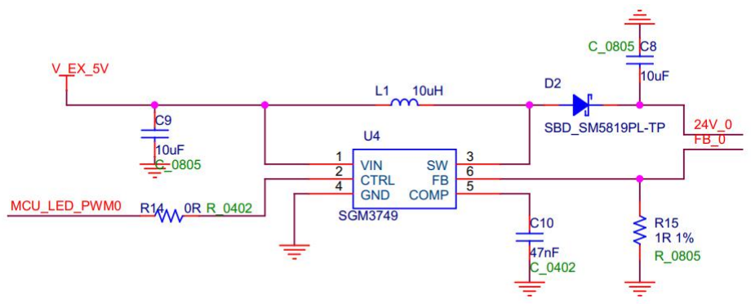
[picture p90: figure]

图 1.3

# 十八、温度与大气压板

## 1.1 接口

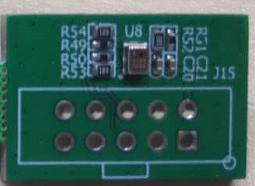
[picture p91: figure]

接在底板的 IIC 接口。底板 I2C 接口上 PIN7 连接器件的中断。详见附录四。

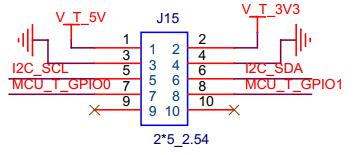
[picture p92: figure]

中移物联网有限公司

图 1.1

## 1.2 电源

电源直接连接底板 3.3V。

## 1.3 电路

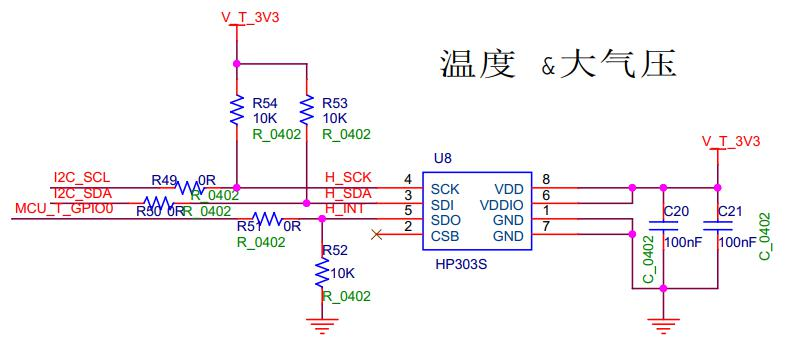
[picture p93: figure]

图 1.3

# 附录一 底板与 MCU 管脚对应关系表

管脚编号 | MCU 核心板管脚名称 | 底板接口对应名称
| | 复用管脚
8 | PC0 I2C1_SCL | | I2C0_SCL
9 | PC1 I2C1_SDA | | I2C0_SDA
29 | PB10 I2C2_SCL | | I2C1_SCL
30 | PB11 I2C2_SDA | | I2C1_SDA
33 | PB12 I2S2_WS | GPIO14 | I2S1_WS
34 | PB13 I2S2_CK | GPIO15 | I2S1_CK

中移物联网有限公司
35 | PB14 I2S2_MCK | GPIO16 | I2S1_MCK
36 | PB15 I2S2_SD | GPIO17 | I2S1_SD
21 | PA5 SPI1_SCK | SPI0_SCK
22 | PA6 SPI1_MISO | SPI0_MISO
23 | PA7 SPI1_MOSI | SPI0_MOSI
41 | PA8 SPI1_NSS | SPI0_NSS
37 | PC6 SPI2_NSS | SPI1_NSS
38 | PC7 SPI2_SCK | SPI1_SCK
39 | PC8 SPI2_MISO | SPI1_MISO
40 | PC9 SPI2_MOSI | SPI1_MOSI
10 | PC2 ADC0_IN13 | ADC0_IN13
11 | PC3 ADC1_IN14 | ADC1_IN14
20 | PA4 DAC_OUT | DAC_OUT
14 | PA0 USART2_CTS | GPIO12 | UART0_CTS
15 | PA1 USART2_RTS | GPIO13 | UART0_RTS
16 | PA2 USART2_TX | | UART0_TX
17 | PA3 USART2_RX | | UART0_RX
42 | PA9 USART1_TX | | UART1_TX
43 | PA10 USART1_RX | | UART1_RX
56 | PC10 | USART3_TX/UART4_TX USART3_RX/UART4_RX | | UART2_TX
57 | PC11 | | | UART2_RX
61 | PB8 CAN_RX | CAN_RX
62 | PB9 CAN_TX | CAN_TX
26 | PB0 TIM1_CH2N/TIM3_CH3 | PWM1
59 | PB7 TIM4_CH2 | PWM0
44 | PA11 USB_DM | USB_DM
45 | PA12 USB_DP | USB_DP
46 | PA13 JTMS/SWDIO | JTMS/SWDIO
49 | PA14 JTCK/SWCLK | JTCK/SWCLK
50 | PA15 JTDI | JTDI
55 | PB3 JTDO-TRACESWO | JTDO-TRACESWO

中移物联网有限公司

2 | PC13 | GPIO8 | | GPIO8
51 | PB4 | GPIO5 | | GPIO5
52 | PB5 | GPIO6 | | GPIO6
53 | PC12 | GPIO7 | | GPIO7
54 | PD2 | GPIO9 | | GPIO9
58 | PB6 | GPIO2 | GPIO10 | GPIO2
24 | PC4 | GPIO3 | GPIO11 | GPIO3
25 | PC5 | GPIO4 | | GPIO4
27 | PB1 | GPIO0 | | GPIO0
28 | PB2 | GPIO1 | | GPIO1

# 附录二 UART 与各模块管脚对应关系表

UART0 接口 | UART1 接口 | UART2 接口 | CAT1 板 | NB 板
UART0_RX | UART1_RX | UART2_RX | UART_TX | UART_TX
UART0_TX | UART1_TX | UART2_TX | UART_RX | UART_RX
UART0_CTS | GPIO0 | GPIO4 | 电源控制（配置高）模组复位
UART0_RTS | GPIO1 | GPIO5 | 模组复位 | 模组唤醒
GPIO0 | GPIO2 | GPIO6 | 模组唤醒 | 电源控制（配置高）
GPIO1 | GPIO3 | GPIO7 | 模组开机 | 模组开机
UART0 接口 | UART1 接口 | UART2 接口 | GNSS | 蓝牙
UART0_RX | UART1_RX | UART2_RX | UART_TX | UART_TX
UART0_TX | UART1_TX | UART2_TX | UART_RX | UART_RX
UART0_CTS | GPIO0 | GPIO4 | 电源控制（配置高）电源控制（配置高）
UART0_RTS | GPIO1 | GPIO5 | 模组复位 | 中断信号
GPIO0 | GPIO2 | GPIO6
GPIO1 | GPIO3 | GPIO7
UART0 接口 | UART1 接口 | UART2 接口 | WIFI | RS485
UART0_RX | UART1_RX | UART2_RX | UART_TX | UART_TX（只测发）
UART0_TX | UART1_TX | UART2_TX | UART_RX | UART_RX
UART0_CTS | GPIO0 | GPIO4 | 电源控制（配置高）电源控制（配置高）
UART0_RTS | GPIO1 | GPIO5 | 模组复位 | 收发控制（配置高）

中移物联网有限公司
GPIO0 | GPIO2 | GPIO6 | WIFI 模组使能
GPIO1 | GPIO3 | GPIO7

# 附录三 SPI 与各模块管脚对应关系表

SPI0 接口 | SPI1 接口 | 以太网 | 9 轴传感器
SPI0_SCK | SPI1_SCK | / | /
SPI0_MOSI | SPI1_MOSI | / | /
SPI0_MISO | SPI1_MISO | / | /
SPI0_NSS | SPI1_NSS | / | /
GPIO2 | GPIO4 | 复位 | 电源控制（配置高）
GPIO3 | GPIO5 | 中断信号 | 中断信号

# 附录四 I2C 与各模块管脚对应关系表

I2C0 接口 | 温度+大气压
I2C0_SCL | /
I2C0_SDA | /
GPIO7 | 配置地址
GPIO8 | /
