Edragon/CMIOT/8_硬件原理图&PCB参考设计/子板/4、GNSS_UM20/阻抗说明文件.docx

单端50欧姆阻抗

1、 走线L1层参考L2层

整体图

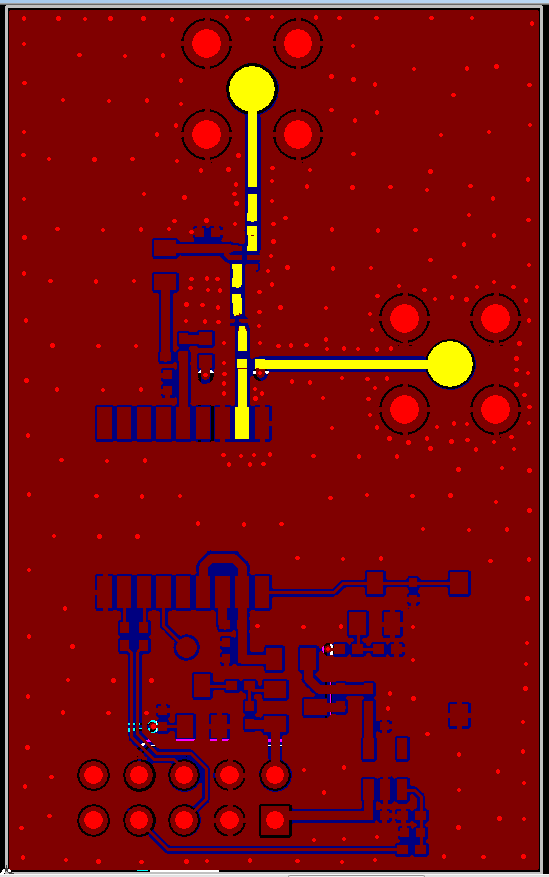
[picture p98: figure]

局部图

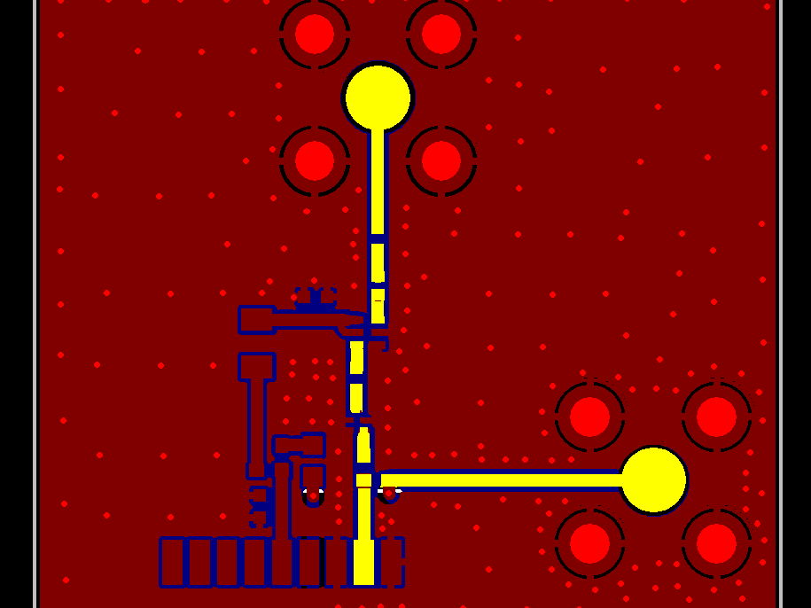
[picture p99: figure]
