Edragon/CMIOT/8_硬件原理图&PCB参考设计/MCU_CM32M101A_00_00_00_BOM.xlsx

Part Type | Part Reference | Value | Description | PCB Footprint | Manufact 1 | Manufact PartNum 1
测试点 | 3V3 5V BOOT0 GND | 5V | 测试点1.2 | TP_1.2
电容 | C1 C2 C7 C8 | 12pF | 12pF;0402;50V;C0G; | C_0402 | TDK | CGA2B2C0G1H120JT0Y0F
电容 | C3 C6 | NC/10uF | Ceramic-CAP;10uF;10V;X5R;0402;20%;SMD;H=0.7mm | C_0402 | Yageo | CC0402MRX5R6BB106
电容 | C4 C5 | NC/100nF | CAP CER 0.1UF 10V X5R 0402 | C_0402 | KEMET | CGA2B2X5R1A104K050BA
电容 | C9 C16 | 4.7uF | Ceramic-CAP;4.7uF;16V;X5R;0402;20%;SMD;H=0.65mm | C_0402 | Yageo | CC0402MRX5R7BB475
电容 | C10 C11 C12 C13 C14 C15 C17 | 100nF | CAP CER 0.1UF 10V X5R 0402 | C_0402 | KEMET | CGA2B2X5R1A104K050BA
LED | D1 D2 | LED_0603_red | 红光LED | LED_0603
J | J1 | MICRO_USB_DIP | MICRO_USB,直插立式。 | USB_MICRO_180 | 首韩 | MICRO 180°ZB
邮票孔 | J2 J3 J4 J5 J6 J7 J8 J9 J10 J11 J12 J13 J14 J15 J16 J17 J18 J19 J20 J21 J22 J23 J24 J25 J26 J27 J28 J29 J30 J31 J32 J33 J34 J35 J36 J37 J38 J39 J40 J41 J42 J43 J44 J45 J46 J47 J48 J49 J50 J51 J52 J53 J54 J55 J56 J57 J58 J59 J60 J61 J62 J63 J64 J65 | stamp hole | 邮票孔;0.6mm;1pin | SIP-1PB
电阻 | R1 R2 R6 R7 R8 R9 R10 R11 R12 R13 R14 | 0R | 0R 0402 0.1W 5% | R_0402 | Samsung Electro-Mechanics | RC1005J000CS
电阻 | R3 R4 R5 R15 | 10K | 10K 0402 1/16W 5% | R_0402 | YAGEO | RC0402JR-0710KL
轻触 | SW1 | TS-1101-C-W | 轻触开关;6.00x3.60mm;50mA@12VDC;H=0.60mm | SW_2PIN_6_3.6_2.5_SMT | XKB(星坤) | TS-1101-C-W
LDO | U1 | NC/AMS1117-3.3-SOT89 | 18V输入，3.3V输出，1A；SOT89封装 | SOT89 | UMW | AMS1117-3.3-SOT89
MCU | U2 | CM32M101A-64 | 32位ARM Cortex-M4内核+FPU；LQFP64 | LQFP64 | 中移物联 | CM32M101A
无源 | X1 | 32.768KHz | 32.768KHz晶体，封装3.2*1.5mm | XTAL_2PIN_3.2_1.5_0.9 | 泰艺电子 | XDMCZLNDDF-32.768KHZ
无源 | X2 | 8MHz | 8MHz晶体，封装3.2*2.5mm | XTAL_4PIN_3.2_2.5 | 泰艺电子 | XXDCCLNANF-8.000000MHZ
