Edragon/CMIOT/8_硬件原理图&PCB参考设计/子板/9、温湿度等/BOM/MCU_EVB_OTHER_0730.xlsx

Part Type | Part Reference | Value | Description | PCB Footprint | Manufact 1 | Manufact PartNum 1
电容 | C1 C2 C3 C4 C5 C20 C21 C22 | 100nF | CAP CER 0.1UF 10V X5R 0402 | C_0402 | KEMET | CGA2B2X5R1A104K050BA
电容 | C6 C7 | 1uF | Ceramic-CAP;1uF;16V;X6S;0402;10%;SMD;H=0.55mm | C_0402 | TDK | C1005X6S1C105K050BC
电容 | C8 C9 C11 C12 C14 C15 C19 | 10uF | 10uF 16V 0805 10% | C_0805 | Samsung | CL21A106KOQNNNE
 | C10 C13 C16 | 47nF | Ceramic-CAP;0.047uF;50V;X7R;0402;10%;SMD;H=0.6mm | C_0402
电容 | C17 | 10nF | X7R;10nF;50V;X7R;0603;±10% | C_0603 | YAGEO | CC0603KRX7R9BB103
电容 | C18 | 2.2uF | Ceramic-CAP;2.2uF;10V;X5R;0603;10%;SMD;H=0.9mm | C_0603 | TDK | C1608X5R1C225K080AB
二极管 | D1 | S6M | 二极管;1000V,6A,VF=1.2V@6A;SMC | D_SS34 | MDD | S6M
肖特基二极管 | D2 D3 D4 | SBD_SM5819PL-TP | VF=450mV@I=500mA;反向电压40V | SOD-123 | MCC | SM5819PL-TP
 | D5 D6 | NC/TVS_SMAJ5.0A | TVS管 | SMAJ5_0A
排针 | J1 J3 J6 J7 J12 J15 J16 | 2*5_2.54 | 直插双排排针;2.54间距;2*5 | CON_DIP_2_5P_2.54_V
排针 | J2 | CON6_DIP_2_3_2.54 | 2x3单排插针，2.54间距,直插 | CON_DIP_2_3_2.54
排针 | J4 | NC/CON_SIP_1*3_2.54 | 1x3单排插针，2.54间距,SIP封装 | CON_SIP_1_3_2.54 |  | CON_SIP_1*3_2.54
J | J5 | WJ301V-5.0-03P | 直插3p螺丝式接线端子;5.0mm | CON_WJ301V-5.0-03P | 康纳克斯 | WJ301V-5.0-03P
J | J8 J9 J10 J11 J13 J14 J17 | terminal | 直插凤凰端子,2Pin,2.54mm,螺丝固定式 | CON_SIP_1_2_2.54 | WE | 6.91211E+11
继电器 | KA1 | HK4100F-DC3V | 3V动作，250VAC，30VDC | DIP_6_HK4100F | 汇科 | HK4100F-DC3V
电感 | L1 L2 L3 | 10uH | 10uH 8040 20% 2.8A | L_SPH8030H100MT | Sunlord | SWPA8040S100MT
BJT | Q1 Q2 Q3 | MMBT5551 | NPN型三极管 | SOT-23 | Micro Commercial Co Micro Commercial Co | MMBT5551
MOS | Q4 Q5 Q10 Q11 | AO3401A | P沟道型MOS;适合用作负载开关或PWM应用;Continuous Drain Current 3.5A | SOT-23 |  | AO3401A
MOS | Q6 Q7 Q12 Q13 | SI2302CDS | N沟道型MOS | SOT-23 |  | SI2302CDS
MOS | Q8 Q9 Q14 Q15 | AO3400A | N沟道型MOS;30V;5.8A;VGS=1.1V | SOT-23 | 友台半导体 | AO3400A
电阻 | R1 R2 R6 R48 R49 R50 R51 | 0R | 0R 0402 1/15W 5% | R_0402 | YAGEO | RC0402JR-070RL
电阻 | R3 R4 R9 R10 R12 R20 R21 R22 R23 R25 R26 R27 R28 R29 R30 R31 R32 R34 R35 R36 R37 R58 R59 R60 | 1K | 1K;0402;1/16W;5%;-55℃~155℃ | R_0402 | YAGEO | RC0402JR-071KL
电阻 | R5 R11 R13 | NC/10K | 10K 0402 1/16W 5% | R_0402 | YAGEO | RC0402JR-0710KL
电阻 | R7 | 240K 1% | RES SMD 240K OHM 1% 1/10W 0603 | R_0603 | YAGEO | RC0603FR-07240KL
湿敏电阻 | R8 | NC/HR202L | 湿敏电阻，2.54管脚间距 | CON_SIP_1_2_2.54 | 广州奥松电子 | HR202L
 | R14 R16 R18 | 0R | 0R 0402 1/15W 5% | R_0402
电阻 | R15 R17 R19 | 1R 1% | 1Ω 1% 1/8W 0805 | R_0805 | Yageo | RC0805FR-071RL
电阻 | R24 R33 R52 R53 R54 R57 | 10K | 10K 0603 1/10W 5% | R_0603 | YAGEO | RC0603JR-0710KL
电阻 | R38 R39 R40 R41 R42 R43 R44 R45 R46 R47 | NC/0R | 0R 0402 1/15W 5% | R_0402 | YAGEO | RC0402JR-070RL
电阻 | R61 | NC/150R | 150R 0402 1/15W 5% | R_0402 | YAGEO | RC0402JR-07150RL
测试点 | TP1 | fault | 测试点1.2 | TP_1.2
IC | U2 | TXB0104PW | 4路电平转换 | TSSOP_14PIN_ADG3304 | TI | TXB0104_PW
LDO | U3 | RP110N181B | 150mA;带关断功能。 | SOT_23_5 | RICOH | RP110N181B
 | U4 U5 U6 | SGM3749 | LED驱动芯片;350mA;38Vout;3V-20V输入 | TSOT_23_6
IC | U7 | DRV8833PW | 电机驱动;2.7~10.8V;1.5A;TSSOP16 | TSSOP_16PIN_DRV8833 | TI | DRV8833PW
IC | U8 | HP303S | 大气压力、温度传感器 | LGA_8PIN_2.0_2.5_1.0 | 华普微电子 | HP303S
IC | U9 | sn65hvd230 | 高速CAN收发器；3V～5V;5Mbit/s；-40℃~150℃;SO8 | SOP_8PIN_AT8563 | TI | sn65hvd230
IC | U10 | ICM-20948 | 9轴传感器；I2C/SPI，VDDIO需要外接1.8V电源。 | QFN_24PIN_3.0_3.0_0.9 | Invensense | ICM-20948
