Edragon/CMIOT/8_硬件原理图&PCB参考设计/子板/1、蓝牙板/JZX_BLE_00_00_00.xlsx

 |  |  |  |  | Capture CIS Standard Bill Of Materials - Standard Report
 |  |  |  |  |  | Report Created on Friday Jun 05 09:06:06 2020
Part Type | Part Reference | Value | Description | PCB Footprint | Manufact 1 | Manufact PartNum 1
电容 | C1 | 1.5pF | 1.5pF 0402 50V 0.25pF | C_0402 | TDK | C1005C0G1H1R5C050BA
电容 | C2 | 1.2pF | Ceramic-CAP;1.2pF;50V;NPO;0402;±0.05pF;SMD;H=0.55mm | C_0402 | YAGEO | CQ0402ARNPO9BN1R2
电容 | C3 C5 C12 C13 C14 | NC | Ceramic-CAP;1.2pF;50V;NPO;0402;±0.05pF;SMD;H=0.55mm | C_0402 | YAGEO | CQ0402ARNPO9BN1R2
电容 | C4 C7 C8 C9 C10 C15 C16 C17 | 1uF | Ceramic-CAP;1uF;16V;X6S;0402;10%;SMD;H=0.55mm | C_0402 | TDK | C1005X6S1C105K050BC
电容 | C6 C11 | 100nF | CAP CER 0.1UF 10V X5R 0402 | C_0402 | KEMET | CGA2B2X5R1A104K050BA
LED | D1 | LED_0603_red | 红光LED | LED_0603
磁珠 | FB1 | 120R@100MHz | 120 Ohms @ 100MHz 3A 0805 | FB_0805 | muRata | BLM21PG121SN1
J | J1 | I-PEX | MHF-Ⅱ/座 （公头）1代2代 | CON_RF_20279-001E-03 |  | I-PEX
排针 | J2 | CON8_2.54 | 1x8单排插针，2.54间距,SIP封装 | CON_SIP_1_8_2.54 |  | CON8_2.54
排针 | J3 | CON6_2.54 | 1x6单排插针，2.54间距,SIP封装 | CON_SIP_1_6_2.54 |  | CON6_2.54
排针 | J4 | CON4_2.54 | 1x4单排插针，2.54间距,SIP封装 | CON_SIP_1_4_2.54 |  | CON4_2.54
排针 | J5 | 2*5_2.54 | 直插双排排针;2.54间距;2*5 | CON_DIP_2_5P_2.54_V
电感 | L1 | 3.3nH | 3.3nH；0402；±0.1nH | L_0402 | muRATA | LQP02HQ3N3B02L
MOS | Q1 Q3 | AO3401A | P沟道型MOS;适合用作负载开关或PWM应用;Continuous Drain Current 3.5A | SOT-23 |  | AO3401A
BJT | Q2 | MMBT5551 | NPN型三极管 | SOT-23 | Micro Commercial Co Micro Commercial Co | MMBT5551
电阻 | R1 | 220R | 220R 0603 1/10W 1% | R_0603 | YAGEO | RC0603FR-07220RL
电阻 | R2 R3 R7 R8 R9 | 0R | 0R 0402 1/15W 5% | R_0402 | YAGEO | RC0402JR-070RL
电阻 | R4 R6 R12 R13 R15 | 10K | 10K 0402 1/16W 5% | R_0402 | YAGEO | RC0402JR-0710KL
电阻 | R10 R11 R14 | NC/0R | 0R 0402 1/15W 5% | R_0402 | YAGEO | RC0402JR-070RL
电阻 | R16 | NC/10K | 10K 0402 1/16W 5% | R_0402 | YAGEO | RC0402JR-0710KL
电阻 | R17 R18 | 1K | 1K;0402;1/16W;5%;-55℃~155℃ | R_0402 | YAGEO | RC0402JR-071KL
天线 | RF1 | ANT | 适用于1.6板厚，2.4GHz；板载单极子天线 | ANT_1.0
IC | U1 | TLSR8232F512ET32 | 32PIN;512KB;蓝牙芯片 | QFN_33PIN_1GND_5_5_0.8 | Telink-Semi | TLSR8232F512ET32
LDO | U2 | RP110N331B | LDO稳压器;输出3.3V@150mA;输入1.4-5.25V;SOT_23_5 | SOT_23_5 | RICOH | RP110N331B
无源 | Y1 | NC/32.768KHz | 32.768KHz±20ppm 7pF -40至85℃ | XTAL_2PIN_FC_135/135R | Epson | FC-135 32.7680KA-AG3
无源 | Y2 | 24MHz | 24 MHz;FA-238 24.000000 MHz 10.0 +20.0-20.0;MHz Range Crystal unit | XTAL_4PIN_FA-238 | EPSON | Q22FA23801201xx
