Edragon/CMIOT/8_硬件原理图&PCB参考设计/子板/2、NB_N10SG/MCU_EVB_NB_00_00_00_0628.xlsx

Part Type | Part Reference | Value | Description | PCB Footprint | Manufact 1 | Manufact PartNum 1
电容 | C3 C15 C20 C23 | 100nF | CAP CER 0.1UF 10V X5R 0402 | C_0402 | KEMET | CGA2B2X5R1A104K050BA
电容 | C1 C2 | 4.7nF | CAP CER 4.7nF 10V X5R 0402 | C_0402
电容 | C4 | 10pF | Ceramic-CAP;10pF;50V;C0G;0402;±0.25pF;SMD;H=0.55mm | C_0402 | TDK | C1005C0G1H100C050BA
电容 | C5 C17 C19 C21 C22 | 33pF | CAP CER 33PF 10V NP0 0402 | C_0402 | TDK | C0402C330K8GAC7867
钽电容 | C6 | 100uF | Tantalumalum-CAP;100uF;6.3V;20%;SMD;H=2.10mm | C_B3528 | KEMET | T520B107M006ATE070
电容 | C7 C10 C11 C12 C16 C18 | 1uF | Ceramic-CAP;1uF;16V;X6S;0402;10%;SMD;H=0.55mm | C_0402 | TDK | C1005X6S1C105K050BC
电容 | C8 C9 C13 C14 | NC/10pF | Ceramic-CAP;10pF;50V;C0G;0402;±0.25pF;SMD;H=0.55mm | C_0402 | TDK | C1005C0G1H100C050BA
ESD | D1 D2 D3 | ESD | ESD防护 | ESD_0402 | 晶焱科技 | AZ5325-01F-R74G
LED | D4 D5 | LED_0603_red | 红光LED | LED_0603
ESD | D6 D7 D8 D9 | NC/ESD | ESD防护 | ESD_0402 | 晶焱科技 | AZ5325-01F-R74G
排针 | J1 | CON8_2.54 | 1x8单排插针，2.54间距,SIP封装 | CON_SIP_1_8_2.54 |  | CON8_2.54
排针 | J2 | 2*5_2.54 | 直插双排排针;2.54间距;2*5 | CON_DIP_2_5P_2.54_V
排针 | J3 J4 J5 | CON4_2.54 | 1x4单排插针，2.54间距,SIP封装 | CON_SIP_1_4_2.54 |  | CON4_2.54
J | J6 | Micro-usb | USB连接器，micro | USB_MICRO |  | Micro-usb
J | J7 J8 | SMA | 直插，立式SMA接头，立式连接 | SMA-KWHD
J | J9 | Nano_SIM | SIM卡槽 | SIM_NANO_6P | BOOMELE(博穆精密) | Nano_SIM
BJT | Q1 Q2 Q4 Q6 Q7 Q8 Q9 Q10 Q11 | MMBT5551 | NPN型三极管 | SOT-23 | Micro Commercial Co Micro Commercial Co | MMBT5551
MOS | Q3 Q5 | AO3401A | P沟道型MOS;适合用作负载开关或PWM应用;Continuous Drain Current 3.5A | SOT-23 |  | AO3401A
电阻 | R1 R6 R7 R9 R13 R14 R19 R21 R23 R30 R31 R32 R34 | 10K | 10K 0402 1/16W 5% | R_0402 | YAGEO | RC0402JR-0710KL
电阻 | R2 R4 R5 R35 R36 | 22R | 22R 0402 1/16W 5% | R_0402 | Samsung Electro-Mechanics | RC1005J220CS
电阻 | R3 R8 R12 R15 R16 R20 | 0R | 0R 0402 1/15W 5% | R_0402 | YAGEO | RC0402JR-070RL
电阻 | R10 R11 | NC | 0R 0603 1/10W 5% | R_0603 | YAGEO | RC0603JR-070RL
电阻 | R17 R18 | NC/0R | 0R 0402 1/15W 5% | R_0402 | YAGEO | RC0402JR-070RL
电阻 | R22 R24 R25 R27 R28 R29 R33 R37 R38 | 1K | 1K;0402;1/16W;5%;-55℃~155℃ | R_0402 | YAGEO | RC0402JR-071KL
电阻 | R26 | NC/10K | 10K 0402 1/16W 5% | R_0402 | YAGEO | RC0402JR-0710KL
轻触 | SW1 SW2 SW3 | TS-1101-C-W | 轻触开关;6.00x3.60mm;50mA@12VDC;H=0.60mm | SW_2PIN_6_3.6_2.5_SMT | XKB(星坤) | TS-1101-C-W
NB+GNSS | U1 | N10SG-DB | NB+GNSS双模，Band 5/Band 8 | QFN_49_PIN_16_18_2.4_N10SG | 中国移动 | N10SG-DB
LDO | U2 | AIC1748-33GU3 | LDO;输入2.3-6v;输出3.3V@600mA;-40~85℃;SOT-23 | SOT-23 | AIC | AIC1748-33GU3
LDO | U3 | RP110N331B | LDO稳压器;输出3.3V@150mA;输入1.4-5.25V;SOT_23_5 | SOT_23_5 | RICOH | RP110N331B
IC | U4 | M2M_2_2 | C2_2_eSIM | DFN_8PIN_2_2_1 | 中国移动 | M2M_2_2
IC | U5 | M2M_5_6 | C5_6_eSIM | QFN_9PIN_1GND_5_6_0.8 | 中国移动 | M2M_5_6
