Edragon/CMIOT/8_硬件原理图&PCB参考设计/子板/3、CAT1_ML302/MCU_EVB_CAT1_00_00_00_0628.xlsx

 |  |  |  |  | Capture CIS Standard Bill Of Materials - Standard Report
 |  |  |  |  |  | Report Created on Sunday Jun 28 19:15:46 2020
Part Type | Part Reference | Value | Description | PCB Footprint | Manufact 1 | Manufact PartNum 1
电容 | C1 C14 C18 | 10uF | Ceramic-CAP;10uF;10V;X5R;0603;10%;SMD;H=1mm | C_0603 | TDK | C1608X5R1A106K080AC
电容 | C2 C6 C9 C16 C19 C22 C25 C31 C32 C33 C34 C35 C36 C37 | 100nF | Ceramic-CAP;0.1uF;50V;X5R;0603;10%;SMD;H=0.9mm | C_0603 | Samsung Electro-Mechanics | CL10B104JO8NNNC
电容 | C3 C4 | NC/10pF | Ceramic-CAP;10pF;50V;C0G;0402;±0.25pF;SMD;H=0.55mm | C_0402 | TDK | C1005C0G1H100C050BA
钽聚合物 | C7 C8 | 220uF | 聚合物电容；220uF;6.3V;20%;ESR=35mΩ；Case_B3528 | C_B3528 | Panasonic | 6TPE220MAZB
钽电容 | C12 C20 | 470uF | Tantalumalum-CAP;470uF;10V;2917;10%;SMD;H=4.3mm | C_E7343 | AVX | TAJE477K010RNJ
电容 | C13 C26 C28 C29 C30 | 33pF | Ceramic-CAP;33pF;50V;C0G/NPO;0603;5%;SMD;H=0.9mm | C_0603 | YAGEO | CC0603KRNPO9BN330
电容 | C23 C24 C27 | 1uF | Ceramic-CAP;1uF;16V;X6S;0402;10%;SMD;H=0.55mm | C_0402 | TDK | C1005X6S1C105K050BC
ESD | D1 D2 D3 D8 D9 D10 D11 | NC/ESD | ESD防护 | ESD_0402 | 晶焱科技 | AZ5325-01F-R74G
稳压 | D4 | PZ3D4V2H | 500mW，4.2V稳压管 |  | prisemi | PZ3D4V2H
LED | D5 D6 D7 | LED_0603_red | 红光LED | LED_0603
磁珠 | FB1 | 120R@100MHz | 120 Ohms @ 100MHz 3A 0805 | FB_0805 | muRata | BLM21PG121SN1
排针 | J1 | 2*5_2.54 | 直插双排排针;2.54间距;2*5 | CON_DIP_2_5P_2.54_V
J | J2 | SMA | 直插，立式SMA接头，立式连接 | SMA-KWHD
排针 | J3 | CON8_2.54 | 1x8单排插针，2.54间距,SIP封装 | CON_SIP_1_8_2.54 |  | CON8_2.54
J | J5 | Micro-usb | USB连接器，micro | USB_MICRO |  | Micro-usb
J | J6 | Nano_SIM | SIM卡槽 | SIM_NANO_6P | BOOMELE(博穆精密) | Nano_SIM
BJT | Q7 Q8 Q9 Q10 Q11 Q12 | MMBT5551 | NPN型三极管 | SOT-23 | Micro Commercial Co Micro Commercial Co | MMBT5551
电阻 | R4 R5 R48 R49 R50 R53 R54 R55 | 0R | 0R 0805 1/8W 5% | R_0805 | YAGEO | RC0805JR-070RL
电阻 | R6 | 100K 1% | 100K 0603 1/10W 1% | R_0603 | YAGEO | RC0603FR-07100KL
电阻 | R8 R17 R31 R32 R40 R41 R42 R43 R44 R46 R47 | 10K | 10K 0402 1/16W 5% | R_0402 | YAGEO | RC0402JR-0710KL
电阻 | R9 | 47K | 47K;0603;1/10W;±5%;-55℃~155℃;H=0.55mm | R_0603 | YAGEO | RC0603JR-0747KL
电阻 | R21 R22 | 22R | 22R 0402 1/16W 5% | R_0402 | Samsung Electro-Mechanics | RC1005J220CS
电阻 | R29 R33 R34 R35 R36 R37 R38 R39 R45 | 1K | 1K;0402;1/16W;5%;-55℃~155℃ | R_0402 | YAGEO | RC0402JR-071KL
轻触 | SW1 SW2 SW3 | TS-1101-C-W | 轻触开关;6.00x3.60mm;50mA@12VDC;H=0.60mm | SW_2PIN_6_3.6_2.5_SMT | XKB(星坤) | TS-1101-C-W
测试点 | TP1 | 4V | 测试点1.2 | TP_1.2
测试点 | TP2 | USB_BOOT | 测试点1.2 | TP_1.2
测试点 | TP3 | MCLK | 测试点1.2 | TP_1.2
测试点 | TP4 | I2C_SDA | 测试点1.2 | TP_1.2
测试点 | TP5 | I2C_SCL | 测试点1.2 | TP_1.2
测试点 | TP6 | DIN | 测试点1.2 | TP_1.2
测试点 | TP7 | DOUT | 测试点1.2 | TP_1.2
测试点 | TP8 | SYNC | 测试点1.2 | TP_1.2
测试点 | TP9 | CLK | 测试点1.2 | TP_1.2
测试点 | TP10 | 2V8 | 测试点1.2 | TP_1.2
LDO | U1 | MIC29302WU-TR | Linear Voltage Regulator IC Positive Adjustable;1Output 1.25V~26V;3A;-40℃~125℃;TO-263-5 | TO_263_5 | Microchip Technology | MIC29302WU-TR
LTE.CAT1 | U2 | ML302 | 模组，LTE Cat1,LCC+LGA,168pin | QFN_168PIN_32_29_2.65_ML302 | CMIOT | ML302
IC | U3 | M2M_2_2 | C2_2_eSIM | DFN_8PIN_2_2_1 | 中国移动 | M2M_2_2
IC | U4 | M2M_5_6 | C5_6_eSIM或SE-SIM | QFN_9PIN_1GND_5_6_0.8 | 中国移动 | M2M_5_6
IC | U5 U6 | SGM4566 | 电平转换；6路，0-6V | TSSOP_16PIN | SGMICRO | SGM4566YTS16G/TR
