Edragon/CMIOT/8_硬件原理图&PCB参考设计/子板/4、GNSS_UM20/MCU_EVB_GNSS_00_00_00_0628.xlsx

 |  |  |  |  | Capture CIS Standard Bill Of Materials - Standard Report
 |  |  |  |  |  | Report Created on Sunday Jun 28 19:14:43 2020
Part Type | Part Reference | Value | Description | PCB Footprint | Manufact 1 | Manufact PartNum 1
电容 | C1 C6 C8 | 100pF | Ceramic-CAP;100pF;16V;CH;0402;10%;SMD;H=0.55mm | C_0402 | TDK | C0402C0G1C101K020BC
电容 | C2 C4 C10 C11 | 100nF | CAP CER 0.1UF 10V X5R 0402 | C_0402 | KEMET | CGA2B2X5R1A104K050BA
电容 | C3 C5 C7 C9 C18 C19 | 1uF | Ceramic-CAP;1uF;16V;X6S;0402;10%;SMD;H=0.55mm | C_0402 | TDK | C1005X6S1C105K050BC
磁珠 | FB1 FB2 | 120R@100MHz | 120 Ohms @ 100MHz 3A 0805 | FB_0805 | muRata | BLM21PG121SN1
排针 | J1 | 2*5_2.54 | 直插双排排针;2.54间距;2*5 | CON_DIP_2_5P_2.54_V
J | J2 J3 | SMA | 直插，立式SMA接头，立式连接 | SMA-KWHD
电感 | L1 | 68nH | 高频电感;68nH;±5%;350mA;380mΩ | L_0603 | Sunlord | SDWL1608C68NJSTF
电感 | L2 | 6.8nH | 6.8nH;±5%;90mΩ;700mA | L_0402 | Sunlord | SDWL1005C6N8JSTFM01
MOS | Q1 | AO3401A | P沟道型MOS;适合用作负载开关或PWM应用;Continuous Drain Current 3.5A | SOT-23 |  | AO3401A
BJT | Q2 Q3 | MMBT5551 | NPN型三极管 | SOT-23 | Micro Commercial Co Micro Commercial Co | MMBT5551
电阻 | R1 R2 R13 R31 | 1K | 1K;0402;1/16W;5%;-55℃~155℃ | R_0402 | YAGEO | RC0402JR-071KL
电阻 | R3 R8 R9 R10 | NC/0R | 0R 0402 1/15W 5% | R_0402 | YAGEO | RC0402JR-070RL
电阻 | R4 R5 R6 R12 R30 | 0R | 0R 0402 1/15W 5% | R_0402 | YAGEO | RC0402JR-070RL
电阻 | R7 R11 R14 | 10K | 10K 0402 1/16W 5% | R_0402 | YAGEO | RC0402JR-0710KL
轻触 | SW1 | TS-1101-C-W | 轻触开关;6.00x3.60mm;50mA@12VDC;H=0.60mm | SW_2PIN_6_3.6_2.5_SMT | XKB(星坤) | TS-1101-C-W
测试点 | TP1 | TP | 测试点1.2 | TP_1.2
GNSS | U1 | UM220-IV M0 | GNSS;BDS;GPS0;QZSS；不支持GLONASS | QFN_18PIN_9.7_10.1_2.5 | 和芯星通 | UM220-IV_M0
LDO | U2 | RP110N331B | LDO稳压器;输出3.3V@150mA;输入1.4-5.25V;SOT_23_5 | SOT_23_5 | RICOH | RP110N331B
IC | U3 | MAX2659ELT+ | GNSS LNA DFN-6 | DFN_6PIN_1_1.5_0.55 | Maxim | MAX2659ELT+
IC | U4 | SAFFB1G56KB0F0A | GNSS_SAW滤波器 | FILTER_5PIN_1.1_0.9_0.5 | muRATA | SAFFB1G56KB0F0A
