Edragon/CMIOT/8_硬件原理图&PCB参考设计/子板/5、电源板/MCU_EVB_PER_00_00_00_1013.xlsx

Part Type | Part Reference | Value | Description | PCB Footprint | Manufact 1 | Manufact PartNum 1
电容 | C1 C7 C8 C9 C10 | 10uF | Ceramic-CAP;10uF;10V;X5R;0603;10%;SMD;H=1mm | C_0603 | TDK | C1608X5R1A106K080AC
电容 | C2 C3 C11 | 100nF | Ceramic-CAP;0.1uF;50V;X5R;0603;10%;SMD;H=0.9mm | C_0603 | Samsung Electro-Mechanics | CL10B104JO8NNNC
钽聚合物 | C4 C5 C6 | 220uF | 聚合物电容；220uF;6.3V;20%;ESR=35mΩ；Case_B3528 | C_B3528 | Panasonic | 6TPE220MAZB
电容 | C12 | 22pF | Ceramic-CAP;22pF;50V;C0G;0603;5%;SMD;H=0.9mm | C_0603 | TDK | C1608C0G1H220J/10
电感 | L1 | 0.47uH | 功率电感;0.47uH;±20% ;4.1A | L_2_2.5_1.2_1.6P | Sunlord | WPN252012ER47MT
电阻 | R2 | 330R 1% |  | R_0603
电阻 | R4 | 200R 1% |  | R_0603
电阻 | R6 R12 | 10K | 10K 0402 1/16W 5% | R_0402 | YAGEO | RC0402JR-0710KL
电阻 | R13 R14 | 0R | 0R 0805 1/8W 5% | R_0805 | YAGEO | RC0805JR-070RL
电阻 | R15 | 100K 1% | 100K 0603 1/10W 1% | R_0603 | YAGEO | RC0603FR-07100KL
电阻 | R16 | 22K 1% | MD 22K OHM 1% 0603 | R_0603 | Yageo | RC0603FR-0722KL
LDO | U1 | MIC29302WU-TR | Linear Voltage Regulator IC Positive Adjustable;1Output 1.25V~26V;3A;-40℃~125℃;TO-263-5 | TO_263_5 | Microchip Technology | MIC29302WU-TR
DC-DC | U2 | SY8893 | 同步降压1.2MHz，2.5V-5.5V输入，3A，ADJ;静态电流50uA | SOT_563 | silergy | SY8893ARC
