Edragon/CMIOT/8_硬件原理图&PCB参考设计/子板/6、WIFI/MCU_EVB_WIFI_00_00_00_0714.xlsx

Part Type | Part Reference | Value | Description | PCB Footprint | Manufact 1 | Manufact PartNum 1
钽电容 | C1 | 100uF | Tantalumalum-CAP;100uF;6.3V;20%;SMD;H=2.10mm | C_B3528 | KEMET | T520B107M006ATE070
电容 | C2 C4 | 1uF | Ceramic-CAP;1uF;16V;X6S;0402;10%;SMD;H=0.55mm | C_0402 | TDK | C1005X6S1C105K050BC
电容 | C3 C5 C7 | 100nF | CAP CER 0.1UF 10V X5R 0402 | C_0402 | KEMET | CGA2B2X5R1A104K050BA
电容 | C6 | NC/1uF | Ceramic-CAP;1uF;16V;X6S;0402;10%;SMD;H=0.55mm | C_0402 | TDK | C1005X6S1C105K050BC
LED | D1 | LED_0603_red | 红光LED | LED_0603
排针 | J1 | 2*5_2.54 | 直插双排排针;2.54间距;2*5 | CON_DIP_2_5P_2.54_V
MOS | Q1 | AO3401A | P沟道型MOS;适合用作负载开关或PWM应用;Continuous Drain Current 3.5A | SOT-23 |  | AO3401A
BJT | Q2 Q3 Q6 | MMBT5551 | NPN型三极管 | SOT-23 | Micro Commercial Co Micro Commercial Co | MMBT5551
MOS | Q4 | NC/AO3401A | P沟道型MOS;适合用作负载开关或PWM应用;Continuous Drain Current 3.5A | SOT-23 |  | AO3401A
BJT | Q5 | NC/MMBT5551 | NPN型三极管 | SOT-23 | Micro Commercial Co Micro Commercial Co | MMBT5551
电阻 | R1 R2 R6 R11 | 0R | 0R 0402 1/15W 5% | R_0402 | YAGEO | RC0402JR-070RL
电阻 | R3 R4 R8 R10 R12 R19 | 10K | 10K 0402 1/16W 5% | R_0402 | YAGEO | RC0402JR-0710KL
电阻 | R5 R7 R9 R17 | 1K | 1K;0402;1/16W;5%;-55℃~155℃ | R_0402 | YAGEO | RC0402JR-071KL
电阻 | R13 R14 | NC/0R | 0R 0402 1/15W 5% | R_0402 | YAGEO | RC0402JR-070RL
电阻 | R15 | NC/1K | 1K;0402;1/16W;5%;-55℃~155℃ | R_0402 | YAGEO | RC0402JR-071KL
电阻 | R16 R18 | NC/10K | 10K 0402 1/16W 5% | R_0402 | YAGEO | RC0402JR-0710KL
轻触 | SW1 | TS-1101-C-W | 轻触开关;6.00x3.60mm;50mA@12VDC;H=0.60mm | SW_2PIN_6_3.6_2.5_SMT | XKB(星坤) | TS-1101-C-W
WIFI | U1 | WG229 | 串口转wifi模块，基于ESP8266EX;内置32Mflash | WG229 | 天工测控 | WG229
LDO | U2 | NC/AIC1748-33GU3 | LDO;输入2.3-6v;输出3.3V@600mA;-40~85℃;SOT-23 | SOT-23 | AIC | AIC1748-33GU3
