Edragon/CMIOT/8_硬件原理图&PCB参考设计/子板/7、RS485/MCU_EVB_485_00_00_00_0714.DSN.xlsx

 |  |  |  |  | Capture CIS Standard Bill Of Materials - Standard Report
 |  |  |  |  |  | Report Created on Tuesday Jul 14 09:59:58 2020
Part Type | Part Reference | Value | Description | PCB Footprint | Manufact 1 | Manufact PartNum 1
电容 | C1 | 100nF | CAP CER 0.1UF 10V X5R 0402 | C_0402 | KEMET | CGA2B2X5R1A104K050BA
电容 | C2 C3 C4 C5 | 1uF | Ceramic-CAP;1uF;16V;X6S;0402;10%;SMD;H=0.55mm | C_0402 | TDK | C1005X6S1C105K050BC
排针 | J1 | 2*5_2.54 | 直插双排排针;2.54间距;2*5 | CON_DIP_2_5P_2.54_V
J | J2 | WJ301V-5.0-03P | 直插3p螺丝式接线端子;5.0mm | CON_WJ301V-5.0-03P | 康纳克斯 | WJ301V-5.0-03P
MOS | Q1 | AO3401A | P沟道型MOS;适合用作负载开关或PWM应用;Continuous Drain Current 3.5A | SOT-23 |  | AO3401A
BJT | Q2 | MMBT5551 | NPN型三极管 | SOT-23 | Micro Commercial Co Micro Commercial Co | MMBT5551
电阻 | R1 R3 R9 | 1K | 1K;0402;1/16W;5%;-55℃~155℃ | R_0402 | YAGEO | RC0402JR-071KL
电阻 | R2 | NC/150R | 150R 0402 1/15W 5% | R_0402 | YAGEO | RC0402JR-07150RL
电阻 | R4 | NC/0R | 0R 0402 1/15W 5% | R_0402 | YAGEO | RC0402JR-070RL
电阻 | R5 R8 | 0R | 0R 0402 1/15W 5% | R_0402 | YAGEO | RC0402JR-070RL
电阻 | R6 R10 | 10K | 10K 0402 1/16W 5% | R_0402 | YAGEO | RC0402JR-0710KL
电阻 | R7 | NC/1K | 1K;0402;1/16W;5%;-55℃~155℃ | R_0402 | YAGEO | RC0402JR-071KL
IC | U1 | TP75176E-VR | RS485芯片；8-MSOP封装；15kV；10Mbps at 5V;6Mbps at 3.3V； | MSOP_8PIN_TP75716 | 3PEAK | TP75176E-VR
LDO | U2 | RP110N331B | LDO稳压器;输出3.3V@150mA;输入1.4-5.25V;SOT_23_5 | SOT_23_5 | RICOH | RP110N331B
