Edragon/CMIOT/8_硬件原理图&PCB参考设计/子板/8、以太网/MCU_EVB_Ethernet_00_00_00_0714.DSN.xlsx

Part Type | Part Reference | Value | Description | PCB Footprint | Manufact 1 | Manufact PartNum 1
电容 | C1 C13 C14 | 10nF | X7R;10nF;50V;X7R;0603;±10% | C_0603 | YAGEO | CC0603KRX7R9BB103
电容 | C2 C3 C4 C5 C6 C7 C8 C16 | 100nF | CAP CER 0.1UF 10V X5R 0402 | C_0402 | KEMET | CGA2B2X5R1A104K050BA
电容 | C9 C10 | 6.8nF | Ceramic-CAP;6800pF;50V;X7R;0402;10%;SMD;H=0.55mm | C_0402 | TDK | C1005X7R1H682K050BA
电容 | C11 C12 | 18pF 5% | 18pF,NP0;50V;0603;±5%; | C_0603 | Yageo | CC0603JRNPO9BN180
电容 | C15 | 4.7uF | Ceramic-CAP;4.7uF;16V;X5R;0402;20%;SMD;H=0.65mm | C_0402 | Yageo | CC0402MRX5R7BB475
电容 | C17 | 1uF | Ceramic-CAP;1uF;16V;X6S;0402;10%;SMD;H=0.55mm | C_0402 | TDK | C1005X6S1C105K050BC
电容 | C18 C19 C20 | NC/1uF | Ceramic-CAP;1uF;16V;X6S;0402;10%;SMD;H=0.55mm | C_0402 | TDK | C1005X6S1C105K050BC
电容 | C21 | 1nF/5% | 1nF,X7R;2KV;1808;±10%; | C_1808 | YAGEO | CC1808KKX7RDBB102
排针 | J1 | 2*5_2.54 | 直插双排排针;2.54间距;2*5 | CON_DIP_2_5P_2.54_V
J | J2 | HR913550A | RJ45网口连接器，带LED,带屏蔽，内置网络变压器 | CON_RJ45_HR913550A | 汉仁 | HR913550A
BJT | Q1 Q3 | MMBT5551 | NPN型三极管 | SOT-23 | Micro Commercial Co Micro Commercial Co | MMBT5551
MOS | Q2 | AO3401A | P沟道型MOS;适合用作负载开关或PWM应用;Continuous Drain Current 3.5A | SOT-23 |  | AO3401A
电阻 | R1 R2 R3 R9 R24 R25 | 10K | 10K 0402 1/16W 5% | R_0402 | YAGEO | RC0402JR-0710KL
电阻 | R4 R5 R12 R15 | 49.9R 1% | 49.9Ω;0603;1/10W;±1%;-55℃~155℃;H=0.55mm | R_0603 | YAGEO | RC0603FR-0749R9L
电阻 | R6 R7 R8 R30 | NC/10K | 10K 0402 1/16W 5% | R_0402 | YAGEO | RC0402JR-0710KL
电阻 | R10 R11 R13 R16 R17 R23 R27 | 0R | 0R 0402 1/15W 5% | R_0402 | YAGEO | RC0402JR-070RL
电阻 | R14 | 10R 1% | 10Ω;0603;1/10W;±1%;-55℃~155℃;H=0.55mm | R_0603 | YAGEO | AF0603JR-0710RL
电阻 | R18 R19 | 220R | 220R 0603 1/10W 1% | R_0603 | YAGEO | RC0603FR-07220RL
电阻 | R20 | 12.4K 1% | 12.4k;0603;1/10W;±1%;-55℃~155℃;H=0.55mm | R_0603 | YAGEO | AC0603FR-0712K4L
电阻 | R21 R28 | NC/0R | 0R 0402 1/15W 5% | R_0402 | YAGEO | RC0402JR-070RL
电阻 | R26 R29 | NC/1K | 1K;0402;1/16W;5%;-55℃~155℃ | R_0402 | YAGEO | RC0402JR-071KL
电阻 | R22 | 1K | 1K;0402;1/16W;5%;-55℃~155℃ | R_0402 | YAGEO | RC0402JR-071KL
电阻 | R31 | 10M | 10M;1206;1/4W;±5%;-55℃~155℃;H=0.55mm | R_1206 | YAGEO | RC1206JR-0710ML
轻触 | SW1 | TS-1101-C-W | 轻触开关;6.00x3.60mm;50mA@12VDC;H=0.60mm | SW_2PIN_6_3.6_2.5_SMT | XKB(星坤) | TS-1101-C-W
测试点 | TP1 | 1V2 | 测试点1.2 | TP_1.2
IC | U1 | W5500_48LQFP | TCP/IP嵌入式以太网控制器；10/100M速率；3.3V电压；-40℃~85℃；LQFP48 | LQFP_48PIN_7_7_1.6 | WIZNET | W5500
LDO | U2 | NC/RP110N331B | LDO稳压器;输出3.3V@150mA;输入1.4-5.25V;SOT_23_5 | SOT_23_5 | RICOH | RP110N331B
无源 | Y1 | 25M | 无源晶体25MHz;49SMD贴片;±30ppm;20pF;25 Ohm(Max) | XTAL_2PIN_12.5_4.5_4.0 | TAITIEN | XJHEELNANF-25M
