Edragon/CMIOT/8_硬件原理图&PCB参考设计/MCU_CM32M101A_00.pdf

5

4

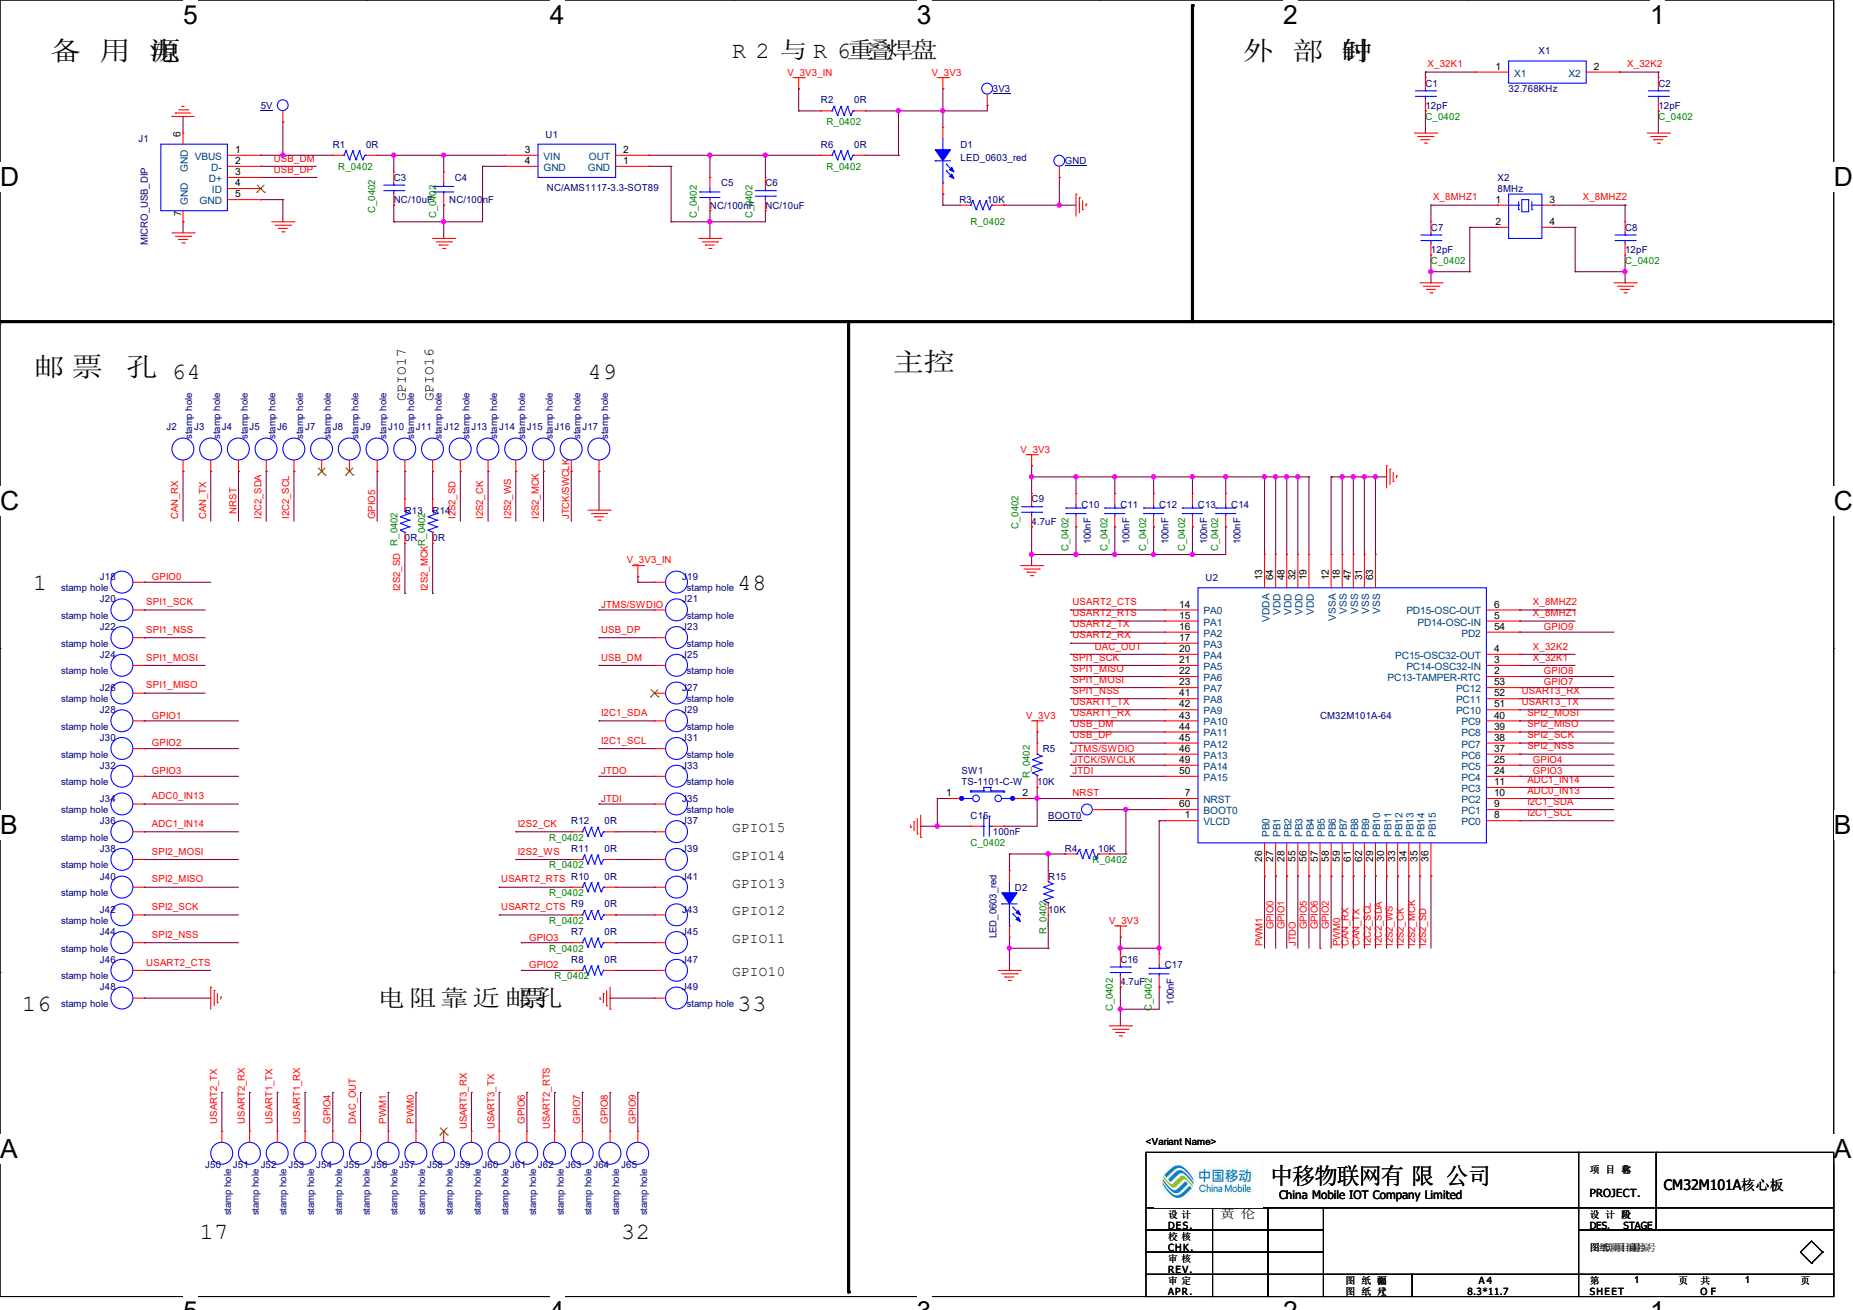
[picture p100: page 1]

J10 stamp hole J2 stamp hole

中移物联网有 限 公司
China Mobile IOT Company Limited
