Edragon/CMIOT/(list of files, drawings)

Other design files:
8_硬件原理图&PCB参考设计/MCU_CM32M101A_00.DSN
8_硬件原理图&PCB参考设计/子板/1、蓝牙板/JZX_BLE_0_0.DSN
8_硬件原理图&PCB参考设计/子板/1、蓝牙板/JZX_BLE_0_0_00_200604.pcb
8_硬件原理图&PCB参考设计/子板/2、NB_N10SG/MCU_EVB_NB_00_01_1014.pcb
8_硬件原理图&PCB参考设计/子板/2、NB_N10SG/MCU_EVB_NB_00_0610.DSN
8_硬件原理图&PCB参考设计/子板/3、CAT1_ML302/MCU_EVB_CAT1_00.DSN
8_硬件原理图&PCB参考设计/子板/3、CAT1_ML302/MCU_EVB_CAT1_00_01_1014.pcb
8_硬件原理图&PCB参考设计/子板/4、GNSS_UM20/MCU_EVB_GNSS_00.DSN
8_硬件原理图&PCB参考设计/子板/4、GNSS_UM20/MCU_EVB_GNSS_00_01_1014.pcb
8_硬件原理图&PCB参考设计/子板/5、电源板/MCU_EVB_PWR_00.DSN
8_硬件原理图&PCB参考设计/子板/5、电源板/MCU_EVB_PWR_00_01_1014.pcb
8_硬件原理图&PCB参考设计/子板/6、WIFI/MCU_EVB_WIFI_00.DSN
8_硬件原理图&PCB参考设计/子板/7、RS485/MCU_EVB_485_00.DSN
8_硬件原理图&PCB参考设计/子板/8、以太网/MCU_EVB_Ethernet_00.DSN
8_硬件原理图&PCB参考设计/子板/9、温湿度等/MCU_EVB_OTHER2_00_00_20200729.pcb
8_硬件原理图&PCB参考设计/子板/9、温湿度等/MCU_EVB_OTHER_0728.DSN
8_硬件原理图&PCB参考设计/子板/9、温湿度等/MCU_EVB_OTHER_1015_00A.pcb
8_硬件原理图&PCB参考设计/子板/11、底板/MCU_EVB_V2_CARRIER_1V0_20200610.DSN
